szymanp135/Tura/doc/Tura_dokumentacja.pdf

# Tura

Fizyczna implementacja maszyny Turinga

Paweł Szymański

Luty 2026

## Spis treści

1 Wstęp | 2
2 Opis zastosowanego modelu | 2
3 Model Działania | 5
4 Fizyczny Opis Działania | 22

1

## 1 Wstęp

Niewątpliwie jednym z najważniejszych osiągnięć ludzkości XX wieku jest wynalazek będący abstrakcyjnym modelem matematycznym. Mowa
oczywiście | o | maszynie | Turinga. | Dzięki | temu | rewolucyjnemu
wynalazkowi dziś jako ludzkość jesteśmy w stanie automatyzować zaawansowane zagadnienia, jak na przykład obróbka i montaż produktów w fabrykach czy rozwiązywanie skomplikowanych obliczeń
matematycznych. | Bez | maszyn | Turinga | nie | mielibyśmy | dziś
komputerów, urządzeń tak uniwersalnych i wszechstronnych jak te które znamy, z których korzystamy i z którego najprawdopodobniej czytelnik czyta tę dokumentację. W ramach urzeczywistnienia matematycznego modelu maszyny Turinga powstał projekt „Tura”, którego zadaniem jest fizyczna implementacja pewnego modelu maszyny. Z racji, iż podstawowy model zakłada nieograniczoną długość taśmy, implementajca maszyny jako takiej nie jest możliwa. Jednak pewien podzbiór maszyn zakłada skończoną długość taśmy. Tym modelem jest maszyna Turinga ograniczona liniowo. Implementowany model, w celu uproszczenia elektronicznych układów, dodatkowo posiada własność akceptującego stanu zatrzymującego.

## 2 Opis zastosowanego modelu

Definicja maszyny Turinga M jest następująca:

M = (Q, Γ, Σ, δ, q0, B, F),

gdzie:

- Q - zbiór stanów,
- Γ - alfabet taśmy,

2

- Σ - alfabet słowa wejściowego, Σ ⊆ Γ,
- δ - funkcja przejścia, δ : Q×Γ → Q×Γ× D, gdzie D jest zbiorem możliwych ruchów głowicy maszyny, D = {L, R},
- q0 - stan początkowy, q0 ∈ Q,
- B - symbol pusty, B ∈ Γ\Σ,
- F - zbiór stanów akceptujących.

Żeby znaleźć jakieś intuicyjne wyobrażenie jak taka maszyna może wyglądać i funkcjonować możemy wyobrazić sobie skrzynkę, w której zamknięty jest układ sterujący urządzeniem oraz przede wszystkim przechowujący jego obecny stan. Obok skrzynki umieszczona jest taśma z symbolami. Ma ona swój początek z jednej strony, jednak z drugiej nie ma końca - jest jednostronnie nieskończona. Taśmę i skrzynkę łączy głowica - czyta ona lub nadpisuje jeden symbol na taśmie oraz przesuwa się po niej. Na początku działania maszyny głowica znajduje się nad skrajnym symbolem taśmy.

Działanie takiej maszyny można porównać do następującej sekwencji czynów:

1. Głowica odczytuje symbol s ∈ Γ z taśmy.
2. Skrzynka na podstawie obecnego stanu q ∈ Q oraz s oblicza nowy stan, symol i kierunek przesunięcia głowicy za pomocą funkcji przejścia: δ(q, s) = (q

′

, s′
, d).
3. Skrzynka zmienia obecny stan z q na q

′
4. Głowica nadpisuje symbol na taśmie s na s

′
, po czym przesuwa się
o jeden symbol się zgodnie z kierunkiem d.

3

5. Sekwencja ta jest powtarzana dopóty, dopóki maszyna nie osiągnie stanu akceptującego.

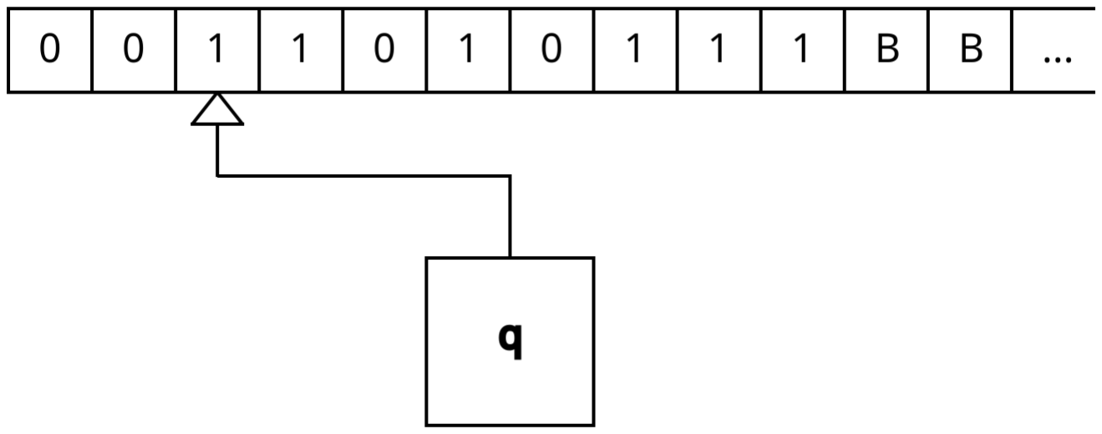
[picture p2: figure]

Rysunek 1: Przykładowa wizualizacja maszyny Turinga

Fizyczne urządzenie cechuje się dodatkowo ograniczoną długością taśmy oraz jednym stanem akceptującym zatrzymującym działanie maszyny. Formalnie ograniczoną długość taśmy można uzyskać poprzez wstawienie wartowników na jej początku oraz końcu, jednak te działanie pozostawione jest dla użytkownika maszyny do samodzielnej implementacji. Zaś stan akceptujący zatrzymujący działanie maszyny oznacza, że F ma dokładnie jeden stan akceptujący qA, po którego osiągnięciu urządzenie zatrzymuje pracę.

4

## 3 Model Działania

### 3.1 Opis Ogólny

Działanie maszyny w skrócie opiera się o zaprogramowanie urządzenia, wykonanie obliczeń i pobranie wyniku.

- Programowanie | odbywa | się | poprzez | zapisanie | wejściowej
zawartości taśmy oraz funkcji przejścia w trzech blokach pamięci (bloku symboli taśmy, bloku funkcji przejścia symbolu tasmy oraz bloku funkcji przejścia stanu).
- Wykonanie obliczeń to uruchomienie urządzenia i pozostawienie w działaniu do czasu osiągnięcia stanu akceptującego.
- Pobranie wyniku jest odczytem zawartości taśmy po zakończeniu działania maszyny.

### 3.2 Opis Szczegółowy

Opis szczegółowy wchodzi już w fizyczną implementację urządzenia. Jego celem jest staranny opis modułów, sygnałów, ich wzajemnej interakcji oraz dokładne wytłumaczenie działania maszyny. Opis w znacznej mierze opiera się o schematy KiCad i korzysta ze stosowanych w nich oznaczeń oraz nazw.

### 3.2.1 Moduły

Maszyna została podzielona na 11 modułów w celu oznakowania jednostek odpowiedzialnych za poszczególne funkcje. Moduły w schematach KiCad zostały otoczone ciemnożłółtymi ramkami i podpisane niebieskim tekstem lub jedynie podpisane niebieskim tekstem w przypadku modułów jednoelementowych.

| | 5

TAPE – Blok pamięci symulujący taśmę. Każda komórka pamięci reprezentuje jeden symbol taśmy. Pojedynczy symbol taśmy składa się z 7 bitów;

TAPE SYMBOL REGISTER – Rejestr przechowujący jeden symbol taśmy. Jest on potrzebny do chwilowego przechowania odczytanego symbolu na czas zapisu nowego do TAPE;

SYMBOL TRANSLATOR – Blok pamięci symulujący funkcję przejścia dla zadanego symbolu oraz stanu zwracający wynik w formie symbolu taśmy (7 bitów) oraz kierunku ruchu głowicy (1 bit);

STATE TRANSLATOR – Blok pamięci symulujący funkcję przejścia dla zadanego symbolu oraz stanu zwracający wynik w formie stanu (8 bitów);

STATE REGISTER – Rejestr przechowujący obecny stan maszyny;

HEADER POSITION – | Zbiór | liczników | binarnych | z | możliwością
inkrementacji oraz dekrementacji reprezentujący usytuowanie głowicy na taśmie (wskazuje obecnie wybrany symbol w TAPE);
HEADER POSITION DIRECTION DISASSEMBLY – | Prosty | multiplekser
sygnału zmiany wartości HEADER POSITION w zależności od kierunku zmiany;
HEADER POSITION CLOCK SYNCHRONIZATION – | Bramka | AND
synchronizująca sygnał zmiany wartości HEADER POSITION z zegarem;

STEP EXECUTION STATE REGISTER – Rejestr przechowujący obecny stan wykonywania ruchu maszyny. Ze względu na brak praktycznego rozwiązania jednoczesnego odczytu i zapisu symbolu taśmy, przeprowadzenie przejścia zostało podzielone na

| | 6

dwa ruchy rozdzielające te operacje; stąd dwa stany wykonania ruchu;

IN-PROGRAM CONTROL LINES BUFFERS – Zestaw buforów oddzielający kontrolne linie sygnałowe generowane przez interfejs zewnętrzny od tych wewnęrznych;

IN-OPERATION CONTROL LINES BUFFER – | Bufor | oddzielający
wewnętrzne linie kontrolne od tych generowanych przez urządzenie podczas pracy;

### 3.2.2 Sygnały

Oznaczenie sygnałów jest takie same jak oznaczenia zastosowane w schematach KiCad. Sygnały z poprzeczką nad nazwą oznaczają, że sygnał jest aktywny dla niskiego poziomu, zaś nieaktywny dla wysokiego.

Lista sygnałów:

D0...7 – Magistrala danych używana do programowania i odczytu danych z maszyny;

S0...6 – Magistrala symbolu taśmy;

SR0...6 – Magistrala symbolu taśmy zapisanego w TAPE SYMBOL REGISTER;

Q0...7 – Magistrala stanu;

QR0...7 – Magistrala stanu zapisanego w STATE REGISTER;

H0...15 – Magistrala z wartością licznika HEADER POSITION;

7

CLK – Sygnał zegarowy wyznaczający rytm pracy; każda zmiana sygnału ze stanu niskiego do wysokiego powoduje przejście STEP EXECUTION STATE REGISTER do następnego stanu; działa pod warunkiem aktywnego sygnału CLK_EN;

CLK_EN – Kontroluje dopływ sygnału CLK do STEP EXECUTION STATE REGISER;

DIR – Ustala kierunek zmiany wartości HEADER POSITION. Wysoki stan sygnału znaczy inkrementację, niski stan dekrementację;

HP_EN – Dopuszcza możliwość zmiany wartości HEADER POSITION;

HP_EN_CLK – sygnał HP_EN zsynchronizowany z zegarem (CLK):
HP_EN_CLK | = | HP_EN · CLK; synchronizuje zmianę wartości
HEADER POSITION z zegarem;

DIR_UP – Decyduje o inkrementacji wartości HEADER POSITION; działa przy przejściu ze stanu niskiego do wysokiego;

DIR_DOWN – Decyduje o dekrementacji wartości HEADER POSITION; działa przy przejściu ze stanu niskiego do wysokiego;

RESET – Resetuje urządzenie, czyli ustawia STEP EXECUTION STATE REGISTER do stanu 0 oraz ustawia wartość HEADER POSITION na 0;

PROGRAM – Ustala tryb pracy. Poziom niski sygnału oznacza tryb programowania maszyny, poziom wysoki zaś tryb wykonywania programu;

PROGRAM – Przeciwieństwo sygnału PROGRAM; sygnał ten jest równoważny OPERATE – podany został jedynie dla czytelności schematu;

8

OPERATE – Przeciwieństwo sygnału PROGRAM. Niski poziom oznacza pracę urządzenia;

DDIR – Ustala kierunek przepływu danych z wewnętrznych modułów wybranych sygnałami CS0, CS1 na magistralę D0...7. Wysoki poziom sygnału oznacza zapis danych z inteferjsu zewnętrznego do modułów wewnątrz urządzenia. Niski poziom oznacza odczyt;

CS0, CS1 – Kombinacja tych sygnałów wybiera wewnętrzną magistralę, która zostanie połączona z zewnętrzną D0...7 oraz wewnętrzny moduł do odczytu/zapisu danych z wybranej magistrali (kierunek zależny od DDIR);

DT – Włącza przesył danych między wewnętrznymi modułami a intefrejsem zewnętrznym; aktywny dla niskiego poziomu;

TSR_WR – Zapisuje dane z magistrali symbolu taśmy S0...6 do TAPE SYMBOL REGISTER; zapis odbywa się podczas przejścia sygnału ze stanu niskiego do wysokiego;

SR_WR – Zapisuje dane z magistrali stanu Q0...7 do STATE REGISER; zapis odbywa się podczas przejścia sygnału ze stanu niskiego do wysokiego;

T_OE – Włącza wyjście danych z TAPE na magistralę S0...6; aktywny dla niskiego poziomu;

T_WE – Włącza zapis danych w TAPE z magistrali S0...6; aktywny dla niskiego poziomu;

SYT_OE – Włącza wyjście danych z SYMBOL TRANSLATOR na magistralę S0...6 oraz sygnał DIR_B; aktywny dla niskiego poziomu;

SYT_WE – Włącza zapis danych w SYMBOL TRANSLATOR z magistrali S0...6 oraz sygnału DIR_B; aktywny dla niskiego poziomu;

9

STT_OE – Włącza wyjście danych ze STATE TRANSLATOR na magistralę Q0...7; aktywny dla niskiego poziomu;

STT_WE – Włącza zapis danych w STATE TRANSLATOR z magistrali Q0...7; aktywny dla niskiego poziomu;

QR_OE – Włącza wyjście danych ze STATE REGISTER na magistralę D0...7; aktywny dla niskiego poziomu;

T_*E_E, SYT_*E_E, ST_*E_E, QR_OE_E – Sygnały odpowiadające tym bez sufiksu „_E”, będące połączone z nimi przez bufor U18 oraz będące wynikiem dekodera wyboru funkcji U19;

T_*E_B, SYT_OE_B, STT_OE_B, DIR_B – Sygnały odpowiadające tym bez sufiksu „_B”, będące połączone z nimi przez bufor U17. Są one sygnałami generowanymi przez maszynę podczas obliczeń potrzebnymi do poprawnej jej samodzielnej pracy;

SYMB_BUF – Włącza przepływ danych z TAPE lub SYMBOL TRANSLATOR (w zależności od wybranego urządzenia sygnałami CS0,1) na magistralę D0...7; aktywny dla niskiego poziomu;

STAT_BUF – Włącza przepływ danych ze STATE TRANSLATOR na magistralę D0...7; aktywny dla niskiego poziomu;

FINISH_STATE – Informuje o osiągnięciu przez maszynę stanu akceptującego i zarazem zatrzymującego pracę; aktywny dla niskiego poziomu.

SEST_STATE – | Wskazuje | obecny | stan | STEP EXECUTION STATE
REGISTER;

10

### 3.2.3 Interfejs zewnętrzny

W celu zasilenia urządzenia oraz komunikacji zastosowany został zewnętrzny interfejs w formie złącza krawędziowego. Składa się on z 17 wyjść sterujących oraz informujacych o stanie maszyny, 11 zasilających oraz 16 niepodpiętych do żadnych sygnałów. W sumie daje to 44 wyjścia. Wszystkie wspomniane sygnały (po za Vcc oraz Vss) zostały wyjaśnione w poprzednim podrozdziale. Wyjścia Vcc oraz Vss są wyjściami odpowiednio zasilania i uziemienia. Vcc powinno mieć napięcie +5V względem Vss.
By uniknąć zbyt podobnych oznaczeń, kierunki sygnałów zamiast „Wej/Wyj” zostały oznaczone angielskimi „In/Out”.

Tabela sygnałów interfejsu:

Num. wyjścia | Sygnały | Kierunek
1-8 | D0...7 | In/Out
9 | CLK | In
10 | RESET | In
11 | PROGRAM | In
12 | DDIR | In
13-14 | CS0,1 | In
15 | DT | In
16 | FINISH_STATE | Out
17 | SESR_STATE | Out

Tabela 1: Lista sygnałów interfejsu zewnętrznego

11

Num. wyjścia | Sygnały | Kierunek
19,21,23,25,27 | Vcc | —
18,20,22,24,26,28 | Vss | —
29-44 | — | —

Tabela 2: Lista sygnałów interfejsu zewnętrznego (cd.)

Oprócz interfejsu zewnętrznego na urządzeniu znajdują się trzy dodatkowe złącza: J2, J3 i J4. Służą one do odczytu wartości odpowiednio TAPE SYMBOL REGISTER, STATE REGISTER oraz HEAD POSITION (złącza te są podłączone do tych modułów bezpośrednio).

### 3.2.4 Programowanie

Programowanie | maszyny | odbywa | się | za | pomocą | interfejsu
zewnętrznego. Dzięki odpowiedniemu wykorzystaniu udostępnionych sygnałów użytkownik jest w stanie manipulować zawartością bloków pamięci TAPE, SYMBOL TRANSLATOR oraz STATE TRANSLATOR.

### 3.2.4.1 Przygotowanie maszyny do programowania

W celu rozpoczęcia programowania maszyny należy wpierw ją do tego przygotować. Zadanie to jest dość proste - wystarczy ustawić sygnał PROGRAM na niski poziom, po czym puścić puls sygnału RESET. Wykres czasowy znajduje się na stronie 15. na rysunku 2.

### 3.2.4.2 Programowanie modułu TAPE (taśmy)

Programowanie modułu TAPE zaczyna się przygotowaniem go do programowania, czyli wybraniem modułu, z użyciem sygnałów CS0,1, ustaleniem kierunku przepływu danych sygnałem DDIR - poziom wysoki

| | 12

dla zapisu - oraz puszczeniem pulsu sygnału RESET.
Następnie zapis słowa wejściowego taśmy odbywa się w pętli: ustala się sybol do zapisu na magistrali D0...6 (proszę zwrócić uwagę na indeks 0...6 - symbol ma 7 bitów), aktywuje się przesył danych (w tym przypadku zapis) do modułu pulsem sygnału DT oraz wysła się dwa pulsy zegara CLK w celu przejścia do następnej komórki pamięci przechowującej zawartość taśmy. Wykres czasowy znajduje się na stronie 16. na rysunku 3.

### 3.2.4.3 Programowanie modułu SYMBOL TRANSLATOR

Podobnie jak w przypadku programowania TAPE, SYMBOL TRANSLATOR również należy przygotować do programowania. W tym celu trzeba wybrać jedynie kierunek DDIR oraz puścić puls sygnału RESET.
Zapis pojedynczej wartości funkcji przejścia z wynikiem w postaci
symbolu | oraz | kierunku | przesunięcia | głowicy | jest | bardziej
skomplikowany w porównaniu do zapisu pojedynczego symbolu taśmy. Główny problem leży w określeniu, która wartość funkcji ma zostać wgrana do modułu, czyli która komórka pamięci ma być zapisana. Aby to sprecyzować należy dokonać zapisu w dwóch rejestrach, które bezpośrednio określają wskazywane miejsce w pamięci: TAPE SYMBOL REGISTER oraz STATE REGISTER. Te dwa rejestry odpowiadają argumentom funkcji przejścia: stanowi oraz symbolowi.
Zatem, żeby wskazać miejsce w pamięci modułu SYMBOL TRANSLATOR do którego należy zapisać wartość, trzeba wpierw wysłać symbol będący jednym z argumentów funkcji przejścia na magistralę D0...6, wybrać wewnętrzną magistralę S0...6 sygnałami CS0,1 oraz wysłać puls zegara w celu zapisania wartości magistrali w TAPE SYMBOL REGISTER. Następnie trzeba wysłać stan będący drugim z argumentów funkcji przejścia na magistralę D0...7, wybrać wewnętrzną magistralę Q0...7 sygnałami CS0,1 oraz wysłać puls zegara w celu zapisania wartości magistrali w STATE REGISTER.
| | | 13

Po tym miejsce w pamięci modułu SYMBOL TRANSLATOR jest wybrane i można przystąpić do zapisu symbolu oraz kierunku wartości funkcji przejścia. Osiąga się to za pomocą wyboru modułu sygnałami CS0,1, umieszczeniu danych do zapisu na magistrali D0...7 oraz puszczeniem pulsu sygnału.
W przypadku programowania wartości funkcji dla argumentu ze stanem akceptującym po wykonaniu zapisu do STATE REGISTER należy puścić puls sygnału RESET w celu wyjścia maszyny ze stanu zatrzymania pracy (zatrzymania wpływu zegara na przejścia między staniami STEP
EXECUTION STATE REGISTER). | Jednak | można | zauważyć, | że
programowanie tych przejść nie ma sensu ze względu na zatrzymanie pracy urządzenia zaraz po przejściu do stanu akceptującego. DT. Wykres czasowy znajduje się na stronie 17. na rysunku 4.

### 3.2.4.4 Programowanie modułu STATE TRANSLATOR

Programowanie STATE TRANSLATOR odbywa się w sposób bardzo zbliżony do SYBMOL TRANSLATOR. Wpierw należy przygotować moduł do programowania co dzieje się poprzez ustawienie kierunku sygnałem DDIR oraz puszczenie pulsu sygnału RESET.
Zapis pojedynczej wartości funkcji przejścia z wynikiem w postaci stanu wymaga dokładnie tego samego procesu wybrania komórki pamięci w STATE TRANSLATOR co w SYMBOL TRANSLATOR. Z tego tytułu opis tego zadania nie został tu omówiony (jednak wciąż znajduje się on na wykresie czasowym).
Po wybraniu miejsca w pamięci modułu STATE TRANSLATOR następuje zapis stanu wartości funkcji przejścia: wybierany jest moduł sygnałami CS0,1, umieszczana jest wartość na magistrali D0...7 oraz puszczony zostaje puls sygnału DT w celu zapisania danych w pamięci. Wykres czasowy znajduje się na stronie 18. na rysunku 5.

Po wykonaniu powyższych czynności, tj. zaprogramowaniu modułów

| 14

TAPE, SYMBOL TRANSLATOR oraz STATE TRANSLATOR urządzenie jest gotowe do wykonania zapisanego programu.

### 3.2.4.5 Wykresy czasowe

Poniżej znajdują się wykresy czasowe uprzednio opisanych czynności.

1 | 2 | 3 | 4 | 5 | 6 | 7 | 8 | 9 | 10 | 11 | 12 | 13 | 14 | 15 | 16 | 17 | 18

PROGRAM

RESET

Rysunek 2: Wykres czasowy przygotowania maszyny do programowania.

Na wykresie czasowym przygotowania maszyny do programowania kolumna 2 przedstawia przejście sygnału PROGRAM do stanu niskiego, kolumna 3 przedstawia puls sygnału RESET. Późniejsze kolumny utrzymują stany sygnałów; zostały umieszczone w celach estetycznych wykresu, podobnie jak ten tekst, który służy częściowemu wypełnieniu pustego miejsca do końca tej strony.

15

RESET

CS1

CS0

DDIR

D0...6

DT

CLK

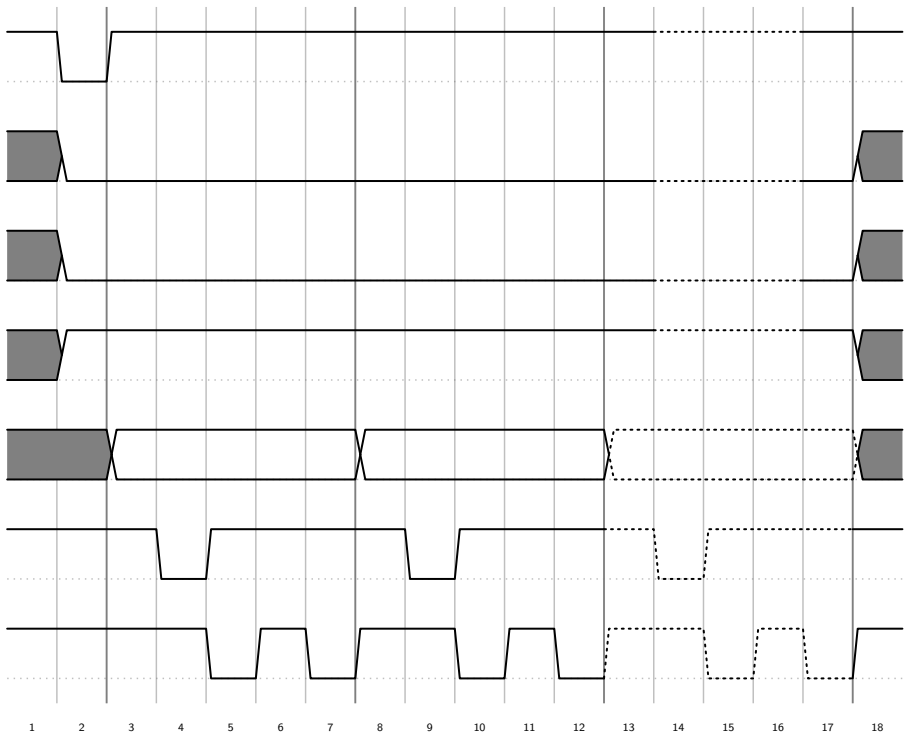
[picture p3: figure]

Rysunek 3: Wykres czasowy programowania TAPE.

Na wykresie czasowym programowania TAPE kolumny 1-2 reprezentują przygotowanie TAPE do programowania. 2-6 i 7-11 przedstawiają dwa pojedyncze zapisy symboli do dwóch kolejnych komórek pamięci w TAPE. Sygnały w kolumnach 13-17 zostały wykropkowane w celu wyeksponowania wielokrotnego powielenia operacji zapisu symbolu.

16

RESET

CS1

CS0

DDIR

D0...7

DT

CLK

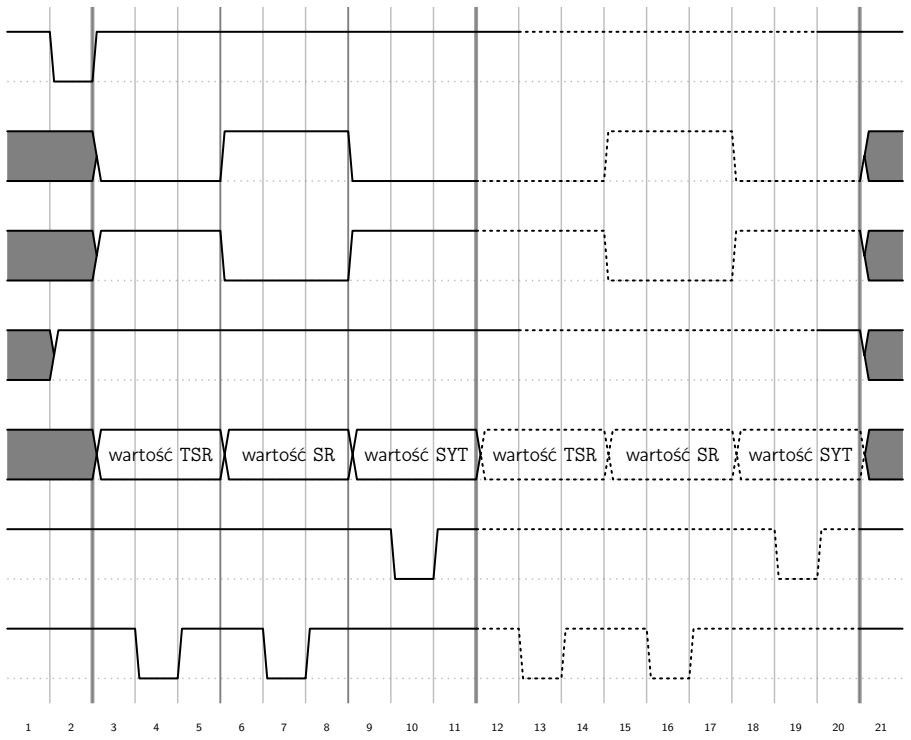
[picture p4: figure]
wartość; TSR; SYT

Rysunek 4: Wykres czasowy programowania SYMBOL TRANSLATOR. Oznaczenia:
TSR – TAPE SYMBOL REGISTER,
SR – STATE REGISTER,
SYT – SYMBOL TRANSLATOR.

Na wykresie czasowym programowania SYMBOL TRANSLATOR kolumny 1-2 reprezentują przygotowanie do programowania; 3-11 przedstawiają programowanie pojedynczej wartości: 3-5 odpowiada za zapis do TAPE SYMBOL REGISTER, 6-8 za zapis do STATE REGISTER, 9-11 za zapis do
SYMBOL TRANSLATOR. | Kolumny | 12-20 | również | przedstawiają
programowanie wartości do SYMBOL TRANSLATOR, jednak zostały one wykropkowane w celu wyeksponowania wielokrotnego powtórzenia tej operacji.

17

RESET

CS1

CS0

DDIR

D0...7

DT

CLK

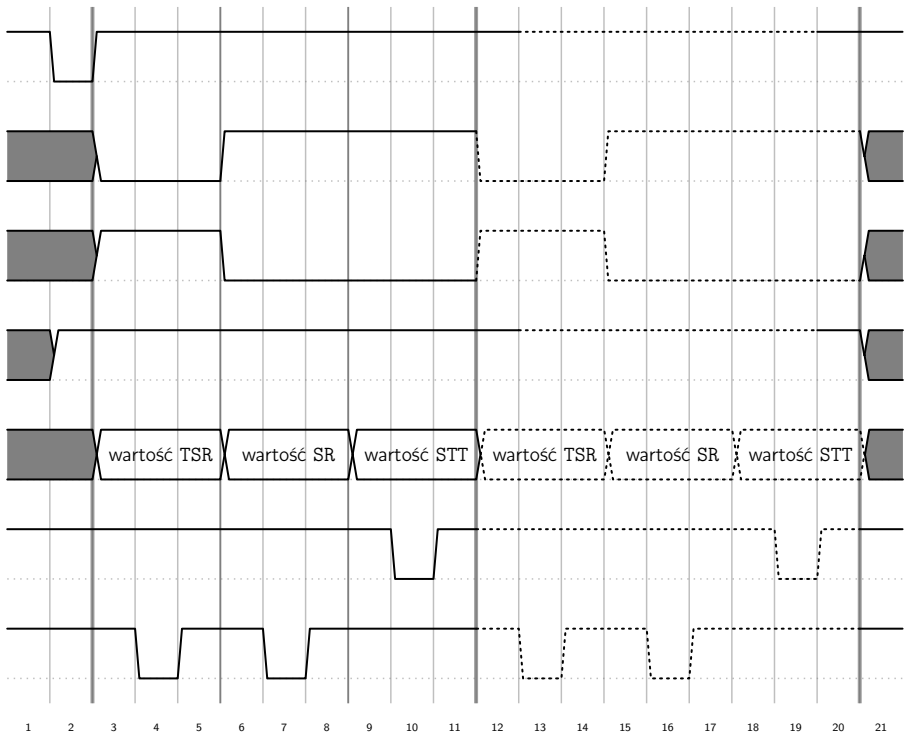
[picture p5: figure]
wartość; TSR; STT

Rysunek 5: Wykres czasowy programowania STATE TRANSLATOR. Oznaczenia:
TSR – TAPE SYMBOL REGISTER,
SR – STATE REGISTER,
STT – STATE TRANSLATOR.

Na wykresie czasowym programowania STATE TRANSLATOR kolumny 1-2 reprezentują przygotowanie do programowania; 3-11 przedstawiają programowanie pojedynczej wartości: 3-5 odpowiada za zapis do TAPE SYMBOL REGISTER, 6-8 za zapis do STATE REGISTER, 9-11 za zapis do
STATE TRANSLATOR. | Kolumny | 12-20 | również | przedstawiają
programowanie wartości do STATE TRANSLATOR, jednak zostały one wykropkowane w celu wyeksponowania wielokrotnego powtórzenia tej operacji.

18

### 3.2.5 Wykonanie Programu

Mając zaprogramowaną maszynę w celu uruchomienia i wykonania jej programu należy ją przygotować. Odbywa się to poprzez wysłanie pulsu sygnału RESET oraz przejście sygnału PROGRAM do stanu wysokiego.

1 | 2 | 3 | 4 | 5 | 6 | 7 | 8 | 9 | 10 | 11 | 12 | 13 | 14 | 15 | 16 | 17 | 18

PROGRAM

RESET

Rysunek 6: Wykres czasowy przygotowania maszyny do pracy.

Następnie całe działanie maszyny opiera się o sygnał zegara CLK. Każde dwa pulsy tego sygnału oznaczają wykonanie jednego ruchu urządzenia. Zegar powinien być dostarczony do momentu osiągnięcia przez maszynę stanu akceptującego zatrzymującego jej działanie.

1 | 2 | 3 | 4 | 5 | 6 | 7 | 8 | 9 | 10 | 11 | 12 | 13 | 14 | 15 | 16 | 17 | 18

CLK

Rysunek 7: Wykres czasowy przykładowago działania zegara.

### 3.2.6 Odczyt Wyniku Programu

Po osiągnięciu przez maszynę stanu akceptującego zatrzymującego jej działanie program został wykonany. W celu odczytu wyniku pracy należy wpierw określić sposób jego zapisu. Jednym z naturalnych sposobów jest umieszczenie wyniku na początku taśmy i pozostawienie głowicy nad pierwszym symbolem taśmy. Ten podrozdział opisze jak

19 odczytać wynik w przypadku zapisu rezultatu tym właśnie sposobem. Jeżeli użytkownik zapisuje wynik inną metodą, będzie musiał samodzielnie opracować sposób jego pobrania.

Odczyt wyniku we wspomnianej postaci jest dość prostym zadaniem. Najpierw trzeba przygotować maszynę do odczytu. Aby tego dokonać należy umieścić maszynę w stan programowania, czyli ustawić sygnał PROGRAM na poziom niski, puścić puls sygnału RESET, wybrać moduł TAPE sygnałami CS0,1 oraz ustalić kierunek przepływu danych na odczyt sygnałem DDIR ustawiając go na niski poziom. Następnie w pętli odczytuje się symbole z taśmy: ustawia się DT na poziom niski, odczytuje dane z magistrali D0...6, przywraca się DT na poziom wysoki, po czym puszcza się dwa pulsy zegara CLK.

Na wykresie czasowym kolumny 1-3 pokazują sekwencję przygotowania maszyny do odczytu. Kolumny 4-8, 9-13 oraz 14-18 reprezentują cykl odczytów pojedynczych symboli z TAPE. Segment 14-18 został wykropkowany w celu wyeksponowania wielokrotnego powtórzenia tej operacji.

S na wykresie oznacza moment w którym dane z TAPE na magistrali D0...6 są poprawne (gotowe do odczytu).

20

PROGRAM

RESET

CS1

CS0

DDIR

DT

D0...6

CLK

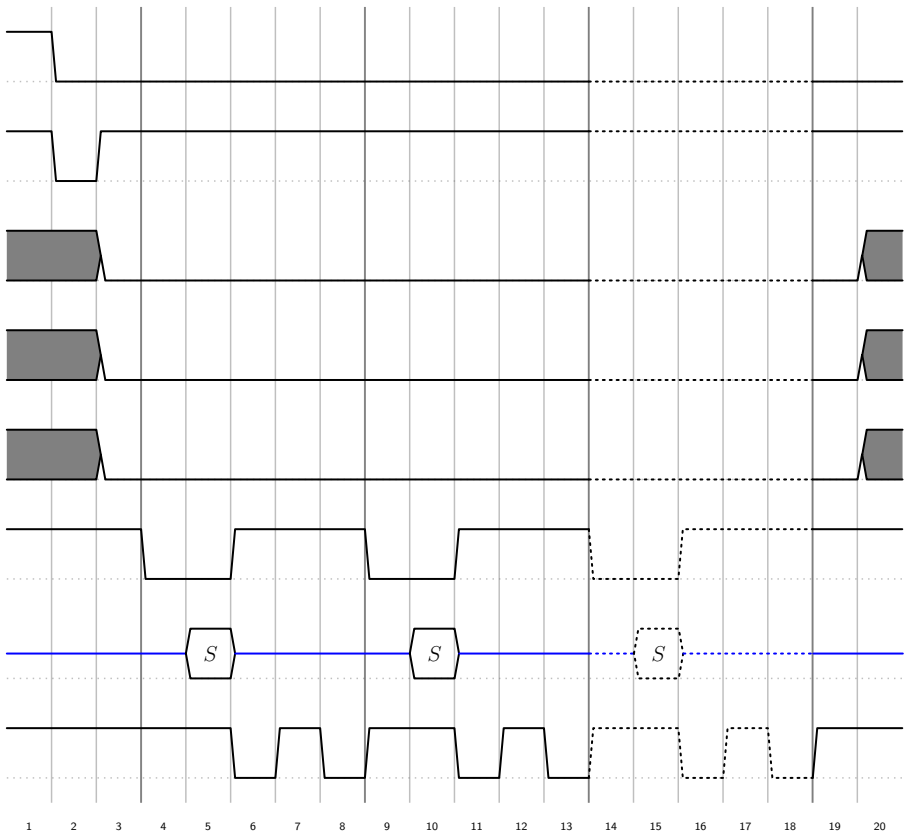
[picture p6: figure]

Rysunek 8: Wykres czasowy odczytu wyniku z maszyny.

21

## 4 Fizyczny Opis Działania

22
