szymanp135/Tura/turing_machine_driver/turing_driver.kicad_pcb

## KiCad design turing_machine_driver/turing_driver.kicad_pcb (2026-03-20)

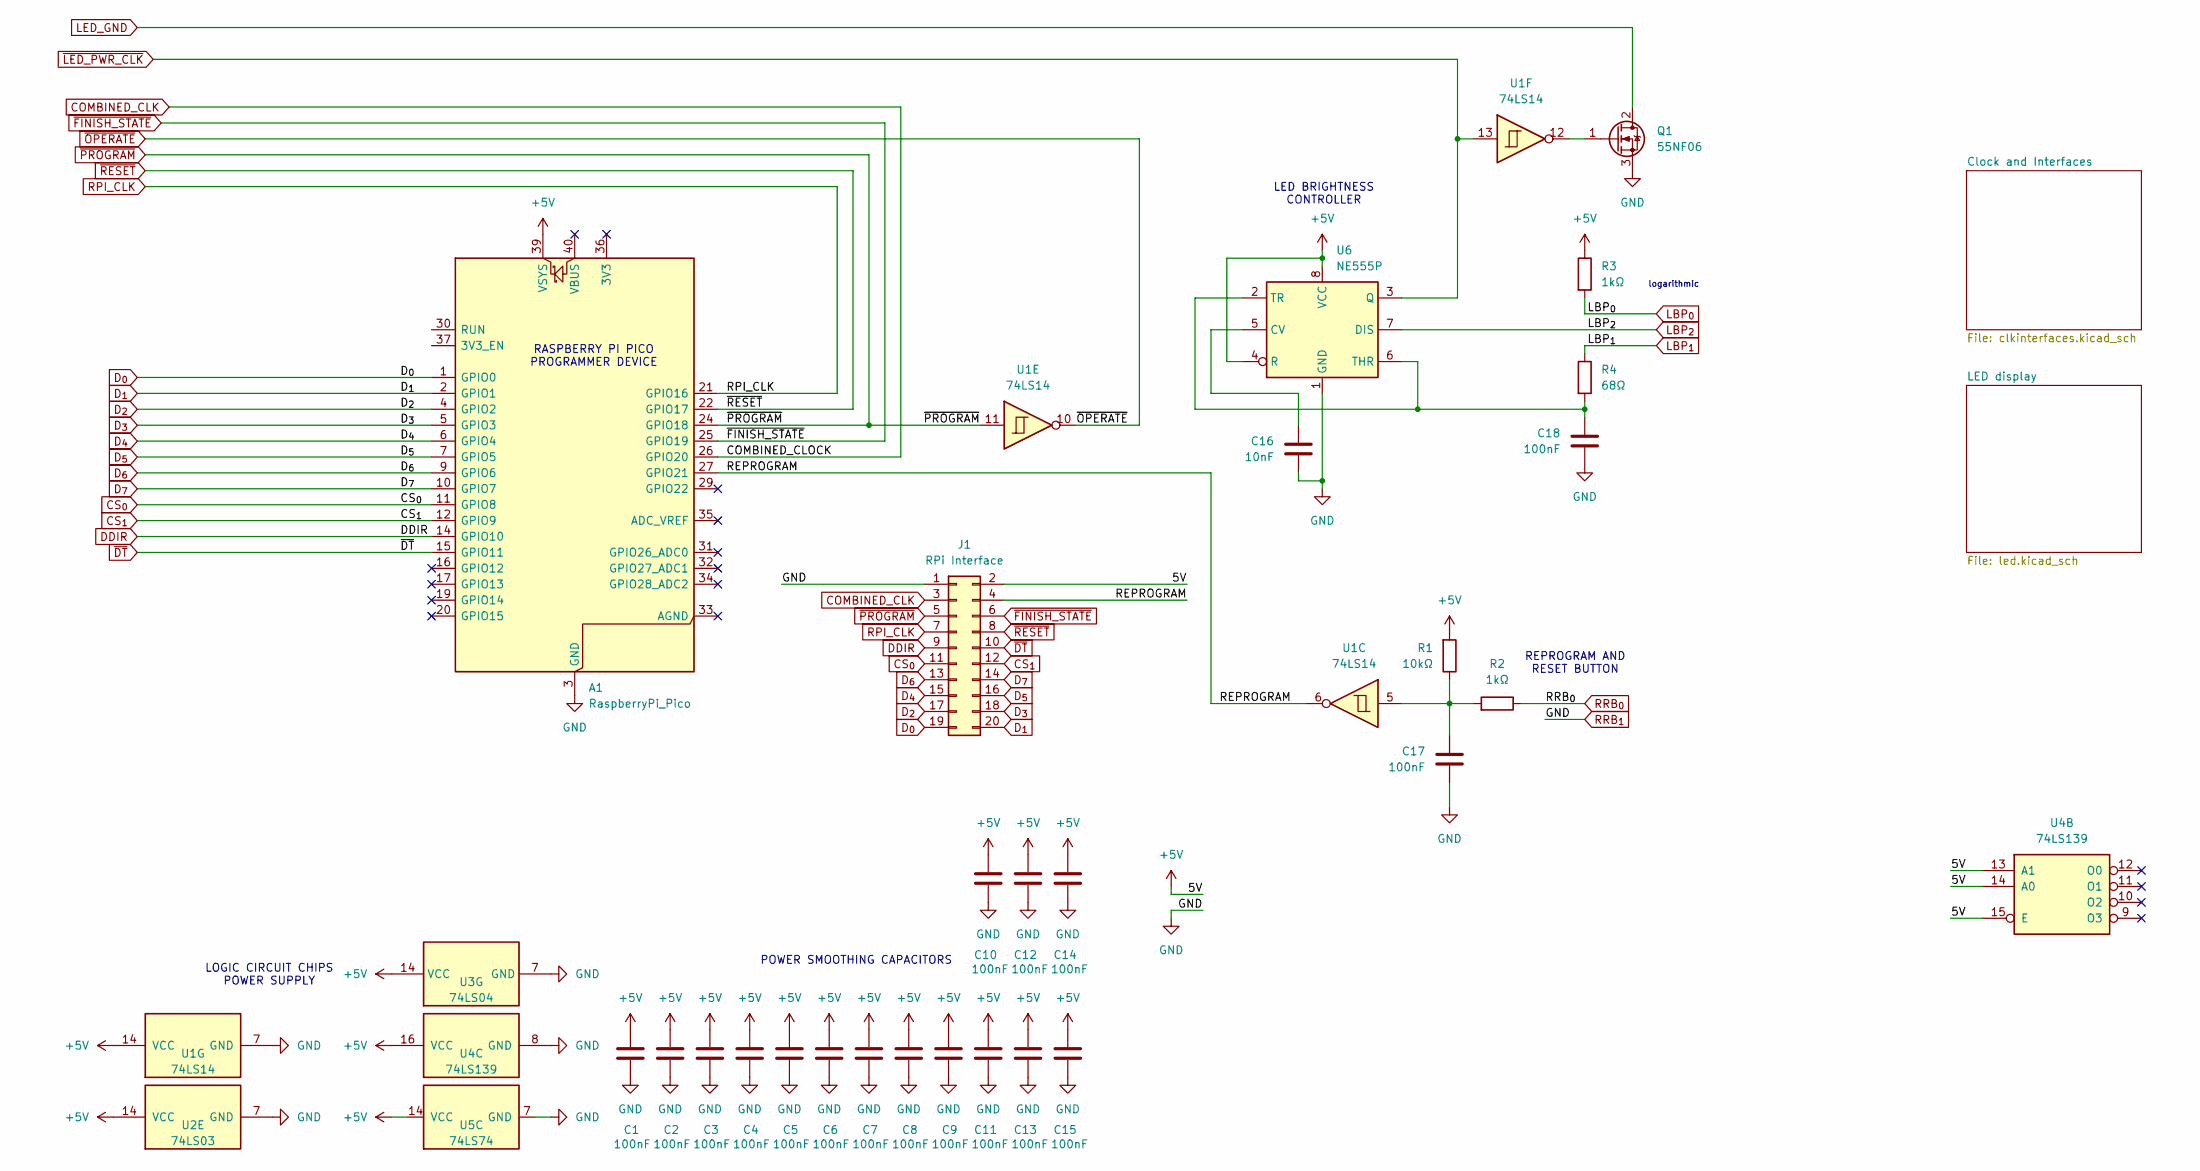
[picture p7: schematic turing_driver.kicad_sch]

Parts:
A1: RaspberryPi_Pico; RaspberryPi_Pico_Common_THT
C1, C2, C3, C4, C5, C6, C7, C8, C9, C10, C11, C12, C13, C14, C15, C17: 100nF; C_Disc_D3.8mm_W2.6mm_P2.50mm
C16: 10nF; C_Disc_D5.1mm_W3.2mm_P5.00mm
C18: 100nF; C_Disc_D5.1mm_W3.2mm_P5.00mm
J1: RPi Interface; IDC-Header_2x10_P2.54mm_Vertical
Q1: 55NF06; TO-220-3_Horizontal_TabDown
R1: 10kΩ; R_Axial_DIN0207_L6.3mm_D2.5mm_P10.16mm_Horizontal
R2, R3: 1kΩ; R_Axial_DIN0207_L6.3mm_D2.5mm_P10.16mm_Horizontal
R4: 68Ω; R_Axial_DIN0207_L6.3mm_D2.5mm_P10.16mm_Horizontal
U1: 74LS14; DIP-14_W7.62mm
U2: 74LS03; DIP-14_W7.62mm
U3: 74LS04; DIP-14_W7.62mm
U4: 74LS139; DIP-16_W7.62mm
U5: 74LS74; DIP-14_W7.62mm
U6: NE555P; DIP-8_W7.62mm

Connections:
/REPROGRAM: A1.27 (GPIO21), J1.4, U1.6
COMBINED_CLK: A1.26 (GPIO20), J1.3; also elsewhere on the board
CS_{0}: A1.11 (GPIO8), J1.11; also elsewhere on the board
CS_{1}: A1.12 (GPIO9), J1.12; also elsewhere on the board
DDIR: A1.14 (GPIO10), J1.9; also elsewhere on the board
D_{0}: A1.1 (GPIO0), J1.19; also elsewhere on the board
D_{1}: A1.2 (GPIO1), J1.20; also elsewhere on the board
D_{2}: A1.4 (GPIO2), J1.17; also elsewhere on the board
D_{3}: A1.5 (GPIO3), J1.18; also elsewhere on the board
D_{4}: A1.6 (GPIO4), J1.15; also elsewhere on the board
D_{5}: A1.7 (GPIO5), J1.16; also elsewhere on the board
D_{6}: A1.9 (GPIO6), J1.13; also elsewhere on the board
D_{7}: A1.10 (GPIO7), J1.14; also elsewhere on the board
LBP_{0}: R3.2; also elsewhere on the board
LBP_{1}: R4.1; also elsewhere on the board
LBP_{2}: U6.7 (DIS); also elsewhere on the board
LED_GND: Q1.2 (D); also elsewhere on the board
LPS_{0}: A1.39 (VSYS), C1.1, C2.1, C3.1, C4.1, C5.1, C6.1, C7.1, C8.1, C9.1, C10.1, C11.1, C12.1, C13.1, C14.1, C15.1, J1.2, R1.2, R3.1, U1.14 (VCC), U2.14 (VCC), U3.14 (VCC), U4.13 (A1), U4.14 (A0), U4.15 (E), U4.16 (VCC), U5.14 (VCC), U6.4 (R), U6.8 (VCC); also elsewhere on the board
unnamed: C17.1, R1.1, R2.2, U1.5
unnamed: Q1.1 (G), U1.12
unnamed: C16.1, U6.5 (CV)
unnamed: C18.1, R4.2, U6.2 (TR), U6.6 (THR)
RPI_CLK: A1.21 (GPIO16), J1.7; also elsewhere on the board
RRB_{0}: R2.1; also elsewhere on the board
RRB_{1}: A1.3 (GND), A1.8 (GND), A1.13 (GND), A1.18 (GND), A1.23 (GND), A1.28 (GND), A1.38 (GND), C1.2, C2.2, C3.2, C4.2, C5.2, C6.2, C7.2, C8.2, C9.2, C10.2, C11.2, C12.2, C13.2, C14.2, C15.2, C16.2, C17.2, C18.2, J1.1, Q1.3 (S), U1.7 (GND), U2.7 (GND), U3.7 (GND), U4.8 (GND), U5.7 (GND), U6.1 (GND); also elsewhere on the board
~DT: A1.15 (GPIO11), J1.10; also elsewhere on the board
~FINISH_STATE: A1.25 (GPIO19), J1.6; also elsewhere on the board
~LED_PWR_CLK: U1.13, U6.3 (Q); also elsewhere on the board
~OPERATE: U1.10; also elsewhere on the board
~PROGRAM: A1.24 (GPIO18), J1.5, U1.11; also elsewhere on the board
~RESET: A1.22 (GPIO17), J1.8; also elsewhere on the board

Notes on the sheet:
RASPBERRY PI PICO PROGRAMMER DEVICE
LOGIC CIRCUIT CHIPS POWER SUPPLY
REPROGRAM AND RESET BUTTON
POWER SMOOTHING CAPACITORS
logarithmic
LED BRIGHTNESS CONTROLLER

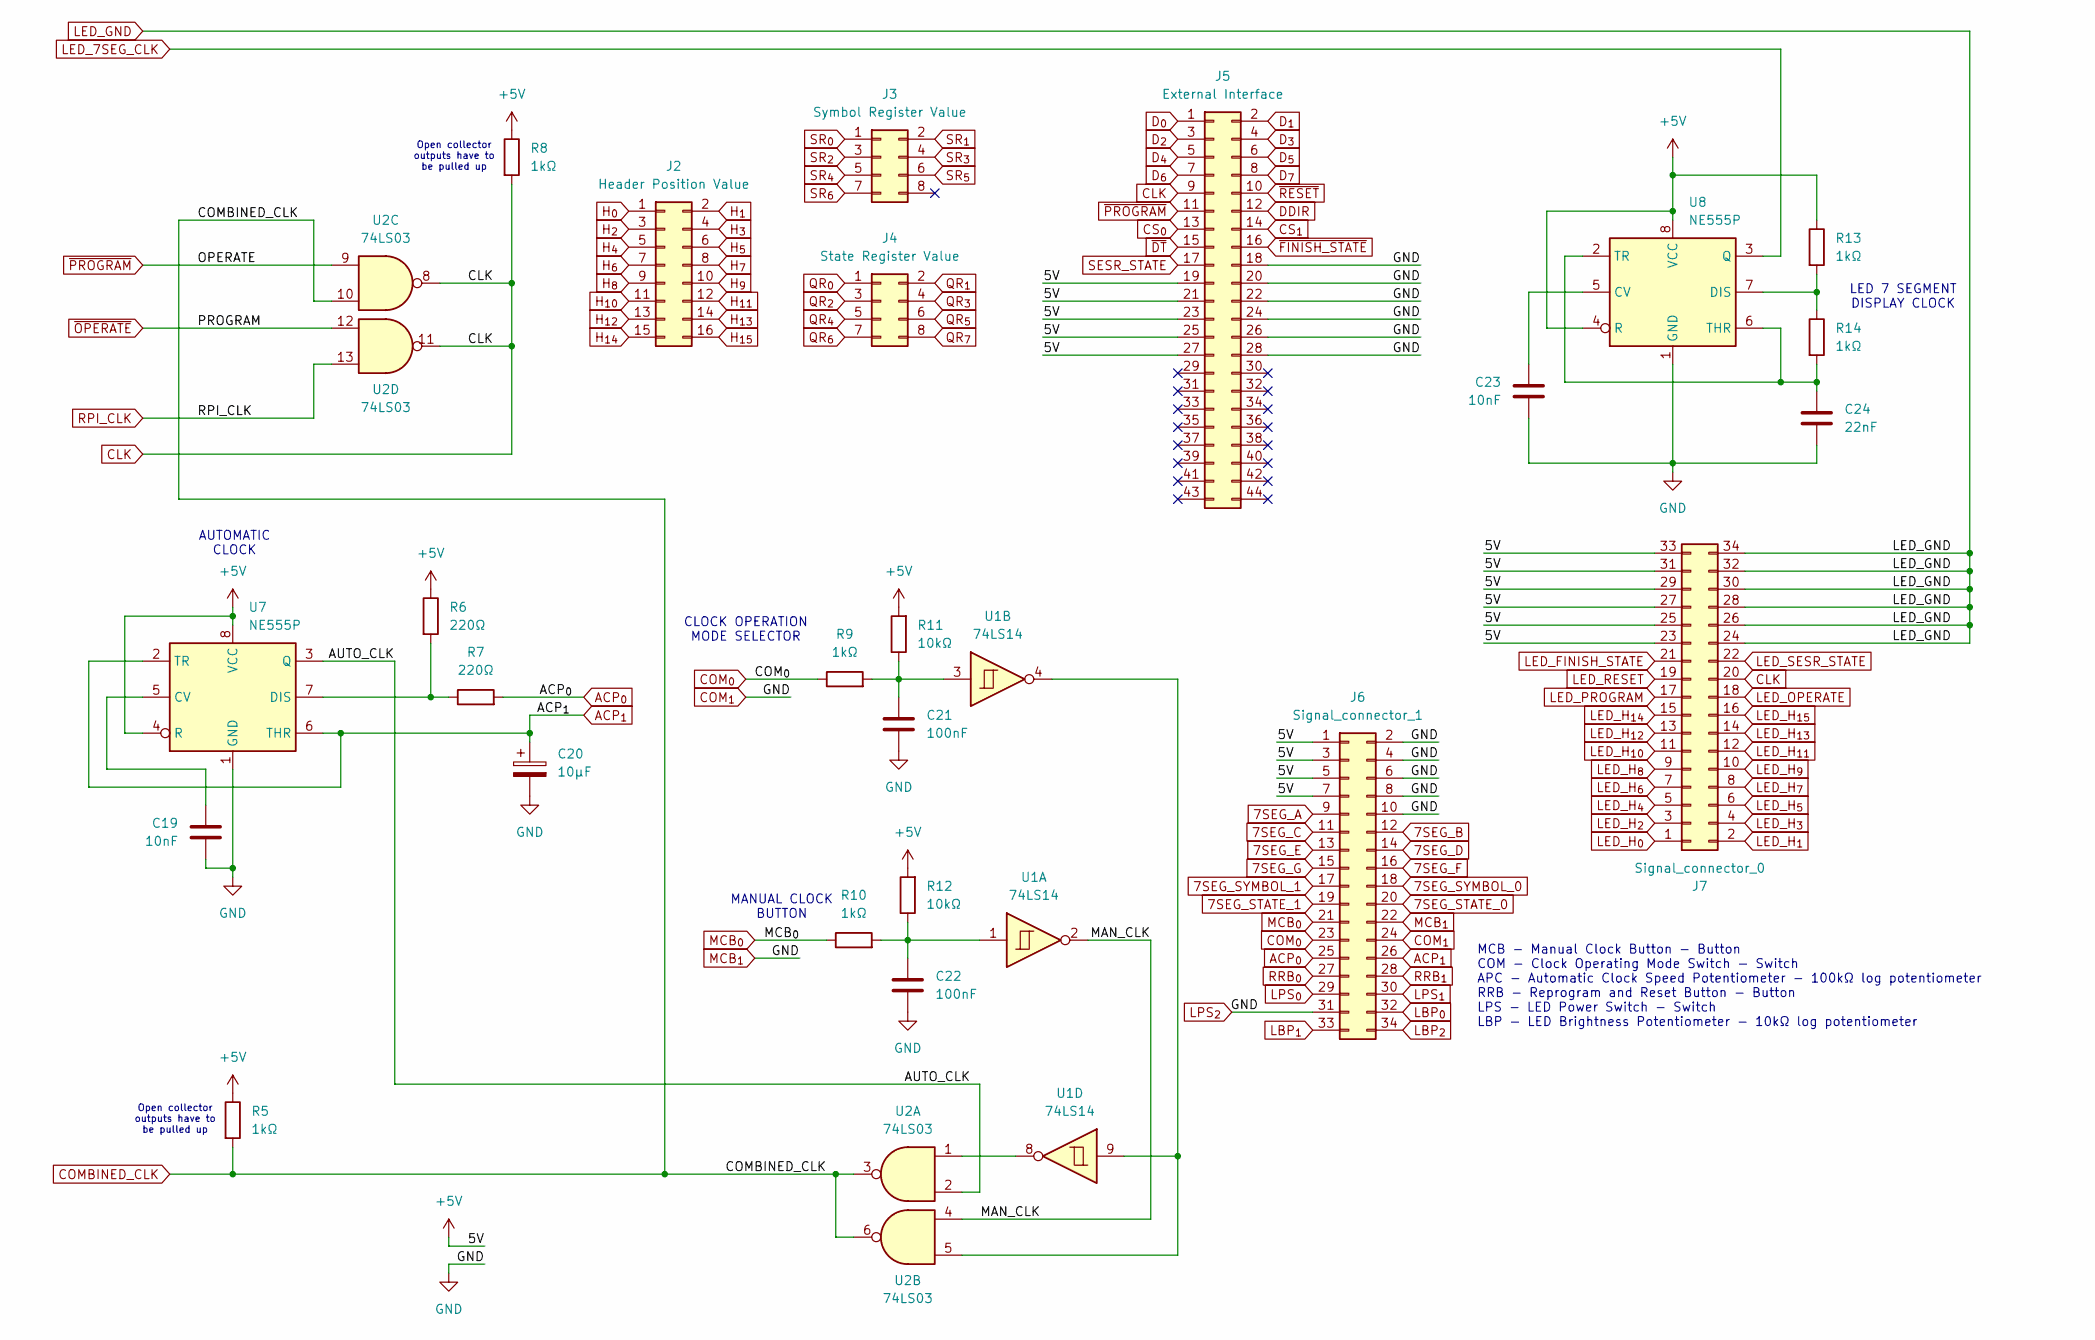
[picture p8: schematic clkinterfaces.kicad_sch]

Parts:
C19, C23: 10nF; C_Disc_D5.1mm_W3.2mm_P5.00mm
C20: 10µF; CP_Radial_D5.0mm_P2.00mm
C21, C22: 100nF; C_Disc_D3.8mm_W2.6mm_P2.50mm
C24: 22nF; C_Disc_D5.1mm_W3.2mm_P5.00mm
J2: Header Position Value; IDC-Header_2x08_P2.54mm_Vertical
J3: Symbol Register Value; IDC-Header_2x04_P2.54mm_Vertical
J4: State Register Value; IDC-Header_2x04_P2.54mm_Vertical
J5: External Interface; Connector_Edge_2x22pin_odd
J6: Signal_connector_1; Connector_Edge_2x17pin_odd
J7: Signal_connector_0; Connector_Edge_2x17pin_odd
R5, R8, R9, R10, R13, R14: 1kΩ; R_Axial_DIN0207_L6.3mm_D2.5mm_P10.16mm_Horizontal
R6, R7: 220Ω; R_Axial_DIN0207_L6.3mm_D2.5mm_P10.16mm_Horizontal
R11, R12: 10kΩ; R_Axial_DIN0207_L6.3mm_D2.5mm_P10.16mm_Horizontal
U1: 74LS14; DIP-14_W7.62mm
U2: 74LS03; DIP-14_W7.62mm
U7, U8: NE555P; DIP-8_W7.62mm

Connections:
7SEG_A: J6.9; also elsewhere on the board
7SEG_B: J6.12; also elsewhere on the board
7SEG_C: J6.11; also elsewhere on the board
7SEG_D: J6.14; also elsewhere on the board
7SEG_E: J6.13; also elsewhere on the board
7SEG_F: J6.16; also elsewhere on the board
7SEG_G: J6.15; also elsewhere on the board
7SEG_STATE_0: J6.20; also elsewhere on the board
7SEG_STATE_1: J6.19; also elsewhere on the board
7SEG_SYMBOL_0: J6.18; also elsewhere on the board
7SEG_SYMBOL_1: J6.17; also elsewhere on the board
/Clock and Interfaces/AUTO_CLK: U2.2, U7.3 (Q)
/Clock and Interfaces/MAN_CLK: U1.2, U2.4
ACP_{0}: J6.25, R7.2
ACP_{1}: C20.1, J6.26, U7.2 (TR), U7.6 (THR)
CLK: J5.9, J7.20, R8.2, U2.8, U2.11; also elsewhere on the board
COMBINED_CLK: R5.2, U2.3, U2.6, U2.10; also elsewhere on the board
COM_{0}: J6.23, R9.1
CS_{0}: J5.13; also elsewhere on the board
CS_{1}: J5.14; also elsewhere on the board
DDIR: J5.12; also elsewhere on the board
D_{0}: J5.1; also elsewhere on the board
D_{1}: J5.2; also elsewhere on the board
D_{2}: J5.3; also elsewhere on the board
D_{3}: J5.4; also elsewhere on the board
D_{4}: J5.5; also elsewhere on the board
D_{5}: J5.6; also elsewhere on the board
D_{6}: J5.7; also elsewhere on the board
D_{7}: J5.8; also elsewhere on the board
H_{0}: J2.1; also elsewhere on the board
H_{1}: J2.2; also elsewhere on the board
H_{2}: J2.3; also elsewhere on the board
H_{3}: J2.4; also elsewhere on the board
H_{4}: J2.5; also elsewhere on the board
H_{5}: J2.6; also elsewhere on the board
H_{6}: J2.7; also elsewhere on the board
H_{7}: J2.8; also elsewhere on the board
H_{8}: J2.9; also elsewhere on the board
H_{9}: J2.10; also elsewhere on the board
H_{10}: J2.11; also elsewhere on the board
H_{11}: J2.12; also elsewhere on the board
H_{12}: J2.13; also elsewhere on the board
H_{13}: J2.14; also elsewhere on the board
H_{14}: J2.15; also elsewhere on the board
H_{15}: J2.16; also elsewhere on the board
LBP_{0}: J6.32; also elsewhere on the board
LBP_{1}: J6.33; also elsewhere on the board
LBP_{2}: J6.34; also elsewhere on the board
LED_7SEG_CLK: U8.3 (Q); also elsewhere on the board
LED_FINISH_STATE: J7.21; also elsewhere on the board
LED_GND: J7.24, J7.26, J7.28, J7.30, J7.32, J7.34; also elsewhere on the board
LED_H_{0}: J7.1; also elsewhere on the board
LED_H_{1}: J7.2; also elsewhere on the board
LED_H_{2}: J7.3; also elsewhere on the board
LED_H_{3}: J7.4; also elsewhere on the board
LED_H_{4}: J7.5; also elsewhere on the board
LED_H_{5}: J7.6; also elsewhere on the board
LED_H_{6}: J7.7; also elsewhere on the board
LED_H_{7}: J7.8; also elsewhere on the board
LED_H_{8}: J7.9; also elsewhere on the board
LED_H_{9}: J7.10; also elsewhere on the board
LED_H_{10}: J7.11; also elsewhere on the board
LED_H_{11}: J7.12; also elsewhere on the board
LED_H_{12}: J7.13; also elsewhere on the board
LED_H_{13}: J7.14; also elsewhere on the board
LED_H_{14}: J7.15; also elsewhere on the board
LED_H_{15}: J7.16; also elsewhere on the board
LED_OPERATE: J7.18; also elsewhere on the board
LED_PROGRAM: J7.17; also elsewhere on the board
LED_RESET: J7.19; also elsewhere on the board
LED_SESR_STATE: J7.22; also elsewhere on the board
LPS_{0}: J5.19, J5.21, J5.23, J5.25, J5.27, J6.1, J6.3, J6.5, J6.7, J6.29, J7.23, J7.25, J7.27, J7.29, J7.31, J7.33, R5.1, R6.1, R8.1, R11.2, R12.2, R13.1, U7.4 (R), U7.8 (VCC), U8.4 (R), U8.8 (VCC); also elsewhere on the board
LPS_{1}: J6.30; also elsewhere on the board
MCB_{0}: J6.21, R10.1
unnamed: C21.1, R9.2, R11.1, U1.3
unnamed: C22.1, R10.2, R12.1, U1.1
unnamed: U1.4, U1.9, U2.5
unnamed: U1.8, U2.1
unnamed: C19.1, U7.5 (CV)
unnamed: R6.2, R7.1, U7.7 (DIS)
unnamed: C23.1, U8.5 (CV)
unnamed: R13.2, R14.1, U8.7 (DIS)
unnamed: C24.1, R14.2, U8.2 (TR), U8.6 (THR)
QR_{0}: J4.1; also elsewhere on the board
QR_{1}: J4.2; also elsewhere on the board
QR_{2}: J4.3; also elsewhere on the board
QR_{3}: J4.4; also elsewhere on the board
QR_{4}: J4.5; also elsewhere on the board
QR_{5}: J4.6; also elsewhere on the board
QR_{6}: J4.7; also elsewhere on the board
QR_{7}: J4.8; also elsewhere on the board
RPI_CLK: U2.13; also elsewhere on the board
RRB_{0}: J6.27; also elsewhere on the board
RRB_{1}: C19.2, C20.2, C21.2, C22.2, C23.2, C24.2, J5.18, J5.20, J5.22, J5.24, J5.26, J5.28, J6.2, J6.4, J6.6, J6.8, J6.10, J6.22, J6.24, J6.28, J6.31, U7.1 (GND), U8.1 (GND); also elsewhere on the board
SESR_STATE: J5.17; also elsewhere on the board
SR_{0}: J3.1; also elsewhere on the board
SR_{1}: J3.2; also elsewhere on the board
SR_{2}: J3.3; also elsewhere on the board
SR_{3}: J3.4; also elsewhere on the board
SR_{4}: J3.5; also elsewhere on the board
SR_{5}: J3.6; also elsewhere on the board
SR_{6}: J3.7; also elsewhere on the board
~DT: J5.15; also elsewhere on the board
~FINISH_STATE: J5.16; also elsewhere on the board
~OPERATE: U2.12; also elsewhere on the board
~PROGRAM: J5.11, U2.9; also elsewhere on the board
~RESET: J5.10; also elsewhere on the board

Notes on the sheet:
AUTOMATIC CLOCK
Open collector outputs have to be pulled up
LED 7 SEGMENT DISPLAY CLOCK
MCB - Manual Clock Button - Button COM - Clock Operating Mode Switch - Switch APC - Automatic Clock Speed Potentiometer - 100kΩ log potentiometer RRB - Reprogram and Reset Button - Button LPS - LED Power Switch - Switch LBP - LED Brightness Potentiometer - 10kΩ log potentiometer
MANUAL CLOCK BUTTON
CLOCK OPERATION MODE SELECTOR

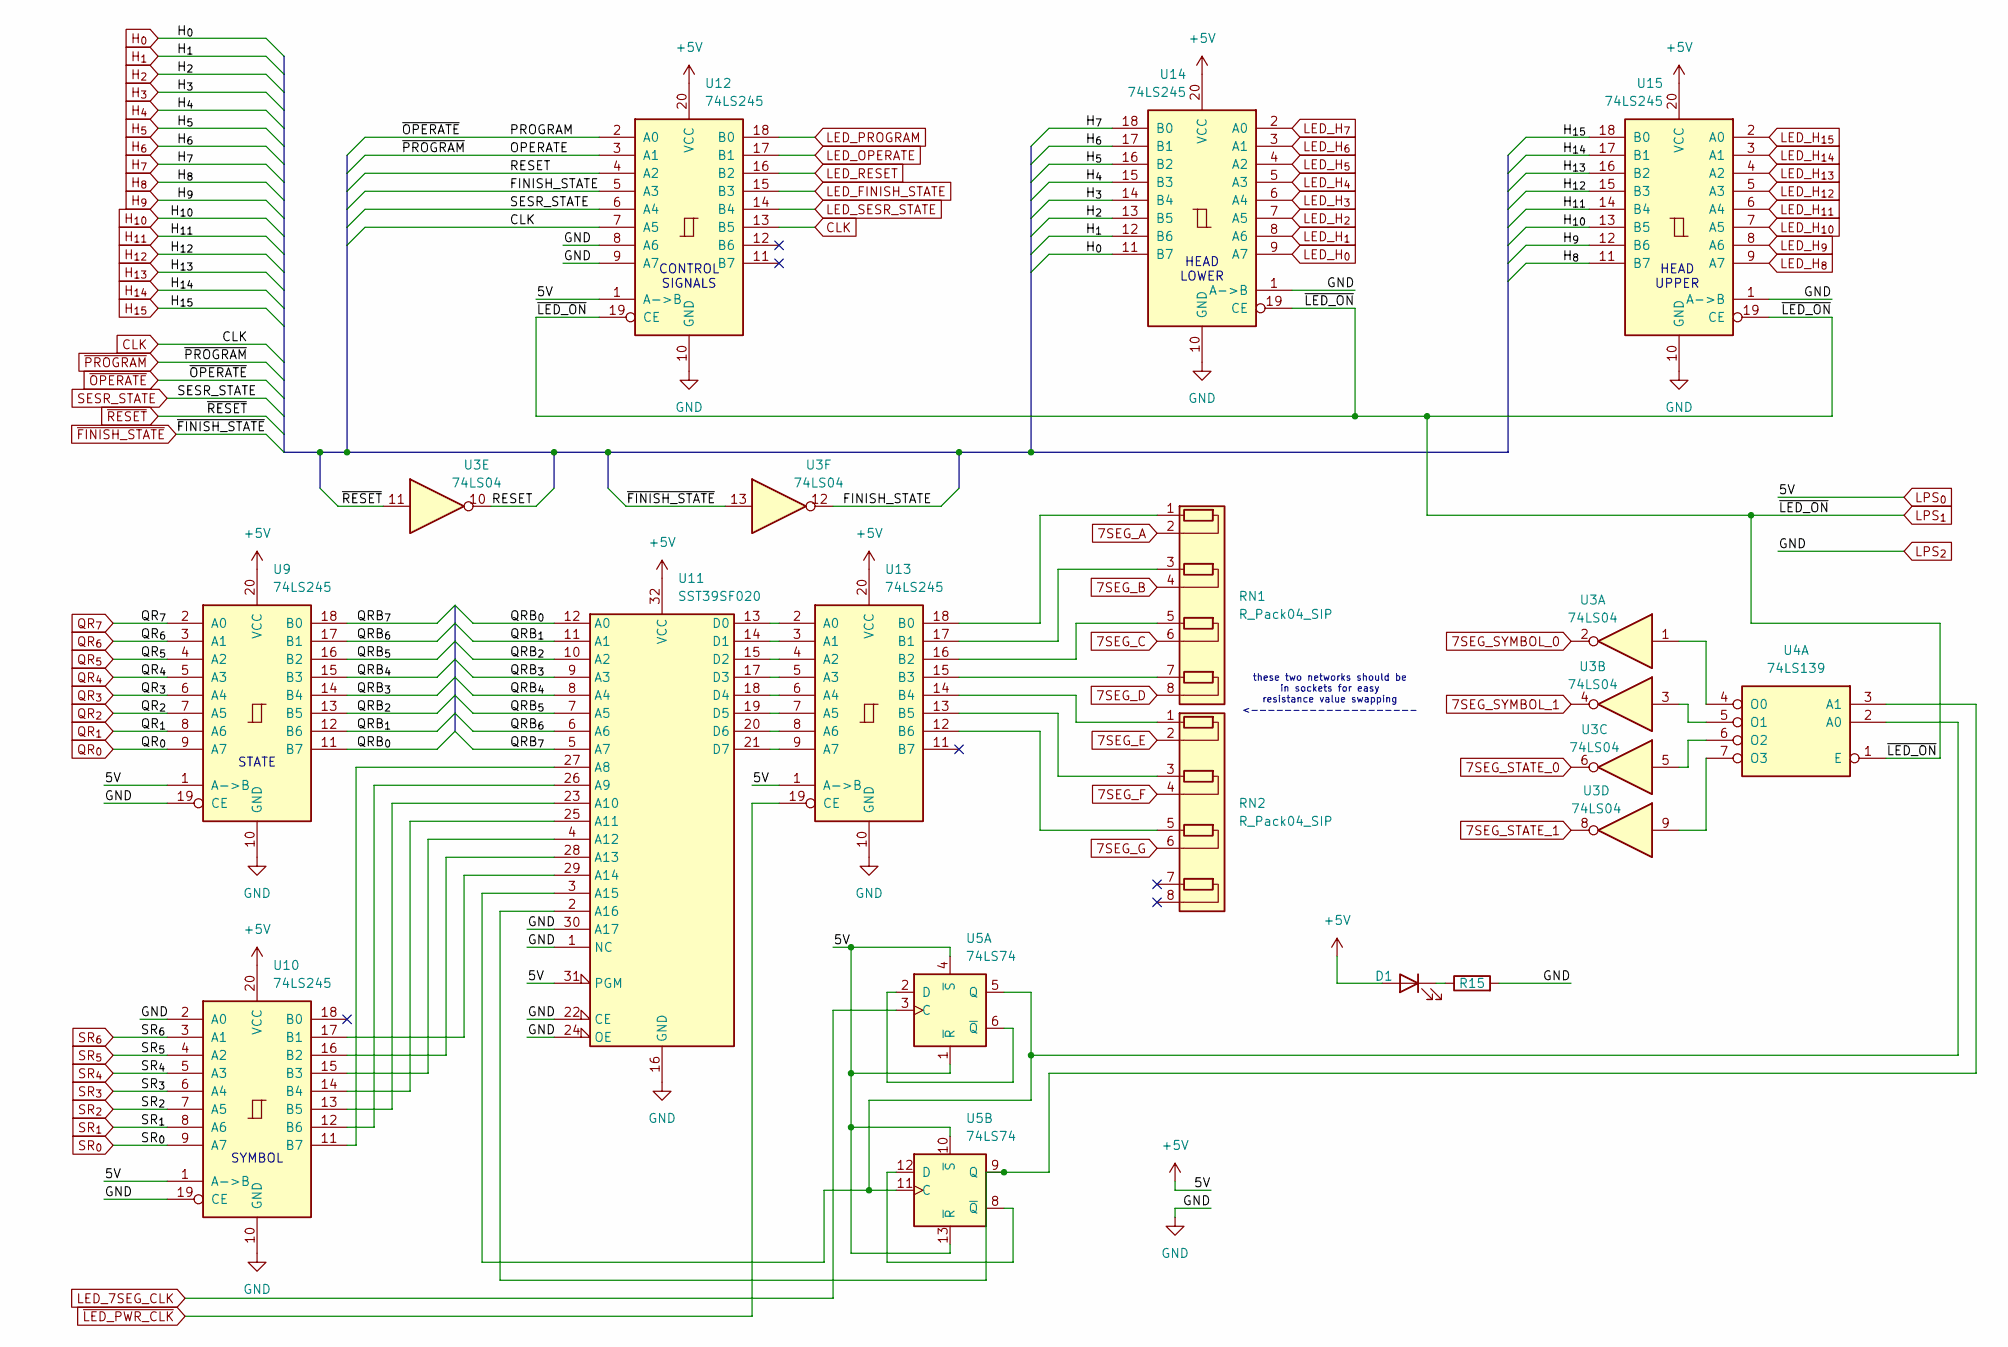
[picture p9: schematic led.kicad_sch]

Parts:
D1: LED_POWER_R; LED_D5.0mm
R15: 330Ω; R_Axial_DIN0207_L6.3mm_D2.5mm_P10.16mm_Horizontal
RN1, RN2: R_Pack04_SIP; R_Array_SIP8
U3: 74LS04; DIP-14_W7.62mm
U4: 74LS139; DIP-16_W7.62mm
U5: 74LS74; DIP-14_W7.62mm
U9, U10, U12, U13, U14, U15: 74LS245; DIP-20_W7.62mm
U11: SST39SF020; DIP-32_W15.24mm

Connections:
7SEG_A: RN1.2 (R1.2); also elsewhere on the board
7SEG_B: RN1.4 (R2.2); also elsewhere on the board
7SEG_C: RN1.6 (R3.2); also elsewhere on the board
7SEG_D: RN1.8 (R4.2); also elsewhere on the board
7SEG_E: RN2.2 (R1.2); also elsewhere on the board
7SEG_F: RN2.4 (R2.2); also elsewhere on the board
7SEG_G: RN2.6 (R3.2); also elsewhere on the board
7SEG_STATE_0: U3.6; also elsewhere on the board
7SEG_STATE_1: U3.8; also elsewhere on the board
7SEG_SYMBOL_0: U3.2; also elsewhere on the board
7SEG_SYMBOL_1: U3.4; also elsewhere on the board
/LED display/FINISH_STATE: U3.12, U12.5 (A3)
/LED display/QRB_{0}: U9.11 (B7), U11.12 (A0)
/LED display/QRB_{1}: U9.12 (B6), U11.11 (A1)
/LED display/QRB_{2}: U9.13 (B5), U11.10 (A2)
/LED display/QRB_{3}: U9.14 (B4), U11.9 (A3)
/LED display/QRB_{4}: U9.15 (B3), U11.8 (A4)
/LED display/QRB_{5}: U9.16 (B2), U11.7 (A5)
/LED display/QRB_{6}: U9.17 (B1), U11.6 (A6)
/LED display/QRB_{7}: U9.18 (B0), U11.5 (A7)
/LED display/RESET: U3.10, U12.4 (A2)
CLK: U12.7 (A5), U12.13 (B5); also elsewhere on the board
H_{0}: U14.11 (B7); also elsewhere on the board
H_{1}: U14.12 (B6); also elsewhere on the board
H_{2}: U14.13 (B5); also elsewhere on the board
H_{3}: U14.14 (B4); also elsewhere on the board
H_{4}: U14.15 (B3); also elsewhere on the board
H_{5}: U14.16 (B2); also elsewhere on the board
H_{6}: U14.17 (B1); also elsewhere on the board
H_{7}: U14.18 (B0); also elsewhere on the board
H_{8}: U15.11 (B7); also elsewhere on the board
H_{9}: U15.12 (B6); also elsewhere on the board
H_{10}: U15.13 (B5); also elsewhere on the board
H_{11}: U15.14 (B4); also elsewhere on the board
H_{12}: U15.15 (B3); also elsewhere on the board
H_{13}: U15.16 (B2); also elsewhere on the board
H_{14}: U15.17 (B1); also elsewhere on the board
H_{15}: U15.18 (B0); also elsewhere on the board
LED_7SEG_CLK: U5.3 (C); also elsewhere on the board
LED_FINISH_STATE: U12.15 (B3); also elsewhere on the board
LED_H_{0}: U14.9 (A7); also elsewhere on the board
LED_H_{1}: U14.8 (A6); also elsewhere on the board
LED_H_{2}: U14.7 (A5); also elsewhere on the board
LED_H_{3}: U14.6 (A4); also elsewhere on the board
LED_H_{4}: U14.5 (A3); also elsewhere on the board
LED_H_{5}: U14.4 (A2); also elsewhere on the board
LED_H_{6}: U14.3 (A1); also elsewhere on the board
LED_H_{7}: U14.2 (A0); also elsewhere on the board
LED_H_{8}: U15.9 (A7); also elsewhere on the board
LED_H_{9}: U15.8 (A6); also elsewhere on the board
LED_H_{10}: U15.7 (A5); also elsewhere on the board
LED_H_{11}: U15.6 (A4); also elsewhere on the board
LED_H_{12}: U15.5 (A3); also elsewhere on the board
LED_H_{13}: U15.4 (A2); also elsewhere on the board
LED_H_{14}: U15.3 (A1); also elsewhere on the board
LED_H_{15}: U15.2 (A0); also elsewhere on the board
LED_OPERATE: U12.17 (B1); also elsewhere on the board
LED_PROGRAM: U12.18 (B0); also elsewhere on the board
LED_RESET: U12.16 (B2); also elsewhere on the board
LED_SESR_STATE: U12.14 (B4); also elsewhere on the board
LPS_{0}: D1.2 (A), U5.1 (~R), U5.4 (~S), U5.10 (~S), U5.13 (~R), U9.1 (A->B), U9.20 (VCC), U10.1 (A->B), U10.20 (VCC), U11.31 (PGM), U11.32 (VCC), U12.1 (A->B), U12.20 (VCC), U13.1 (A->B), U13.20 (VCC), U14.20 (VCC), U15.20 (VCC); also elsewhere on the board
LPS_{1}: U4.1 (E), U12.19 (CE), U14.19 (CE), U15.19 (CE); also elsewhere on the board
unnamed: D1.1 (K), R15.1
unnamed: RN1.1 (R1.1), U13.18 (B0)
unnamed: RN1.3 (R2.1), U13.17 (B1)
unnamed: RN1.5 (R3.1), U13.16 (B2)
unnamed: RN1.7 (R4.1), U13.15 (B3)
unnamed: RN2.1 (R1.1), U13.14 (B4)
unnamed: RN2.3 (R2.1), U13.13 (B5)
unnamed: RN2.5 (R3.1), U13.12 (B6)
unnamed: U3.1, U4.4 (O0)
unnamed: U3.3, U4.5 (O1)
unnamed: U3.5, U4.6 (O2)
unnamed: U3.9, U4.7 (O3)
unnamed: U5.2 (D), U5.6 (~Q)
unnamed: U5.8 (~Q), U5.12 (D)
unnamed: U10.17 (B1), U11.29 (A14)
unnamed: U10.16 (B2), U11.28 (A13)
unnamed: U10.15 (B3), U11.4 (A12)
unnamed: U10.14 (B4), U11.25 (A11)
unnamed: U10.13 (B5), U11.23 (A10)
unnamed: U10.12 (B6), U11.26 (A9)
unnamed: U10.11 (B7), U11.27 (A8)
unnamed: U4.2 (A0), U5.5 (Q), U5.11 (C), U11.3 (A15)
unnamed: U4.3 (A1), U5.9 (Q), U11.2 (A16)
unnamed: U11.13 (D0), U13.2 (A0)
unnamed: U11.14 (D1), U13.3 (A1)
unnamed: U11.15 (D2), U13.4 (A2)
unnamed: U11.17 (D3), U13.5 (A3)
unnamed: U11.18 (D4), U13.6 (A4)
unnamed: U11.19 (D5), U13.7 (A5)
unnamed: U11.20 (D6), U13.8 (A6)
unnamed: U11.21 (D7), U13.9 (A7)
QR_{0}: U9.9 (A7); also elsewhere on the board
QR_{1}: U9.8 (A6); also elsewhere on the board
QR_{2}: U9.7 (A5); also elsewhere on the board
QR_{3}: U9.6 (A4); also elsewhere on the board
QR_{4}: U9.5 (A3); also elsewhere on the board
QR_{5}: U9.4 (A2); also elsewhere on the board
QR_{6}: U9.3 (A1); also elsewhere on the board
QR_{7}: U9.2 (A0); also elsewhere on the board
RRB_{1}: R15.2, U9.10 (GND), U9.19 (CE), U10.2 (A0), U10.10 (GND), U10.19 (CE), U11.1 (NC), U11.16 (GND), U11.22 (CE), U11.24 (OE), U11.30 (A17), U12.8 (A6), U12.9 (A7), U12.10 (GND), U13.10 (GND), U14.1 (A->B), U14.10 (GND), U15.1 (A->B), U15.10 (GND); also elsewhere on the board
SESR_STATE: U12.6 (A4); also elsewhere on the board
SR_{0}: U10.9 (A7); also elsewhere on the board
SR_{1}: U10.8 (A6); also elsewhere on the board
SR_{2}: U10.7 (A5); also elsewhere on the board
SR_{3}: U10.6 (A4); also elsewhere on the board
SR_{4}: U10.5 (A3); also elsewhere on the board
SR_{5}: U10.4 (A2); also elsewhere on the board
SR_{6}: U10.3 (A1); also elsewhere on the board
~FINISH_STATE: U3.13; also elsewhere on the board
~LED_PWR_CLK: U13.19 (CE); also elsewhere on the board
~OPERATE: U12.2 (A0); also elsewhere on the board
~PROGRAM: U12.3 (A1); also elsewhere on the board
~RESET: U3.11; also elsewhere on the board

Notes on the sheet:
HEAD UPPER
SYMBOL
CONTROL SIGNALS
these two networks should be in sockets for easy resistance value swapping <--------------------
HEAD LOWER
STATE

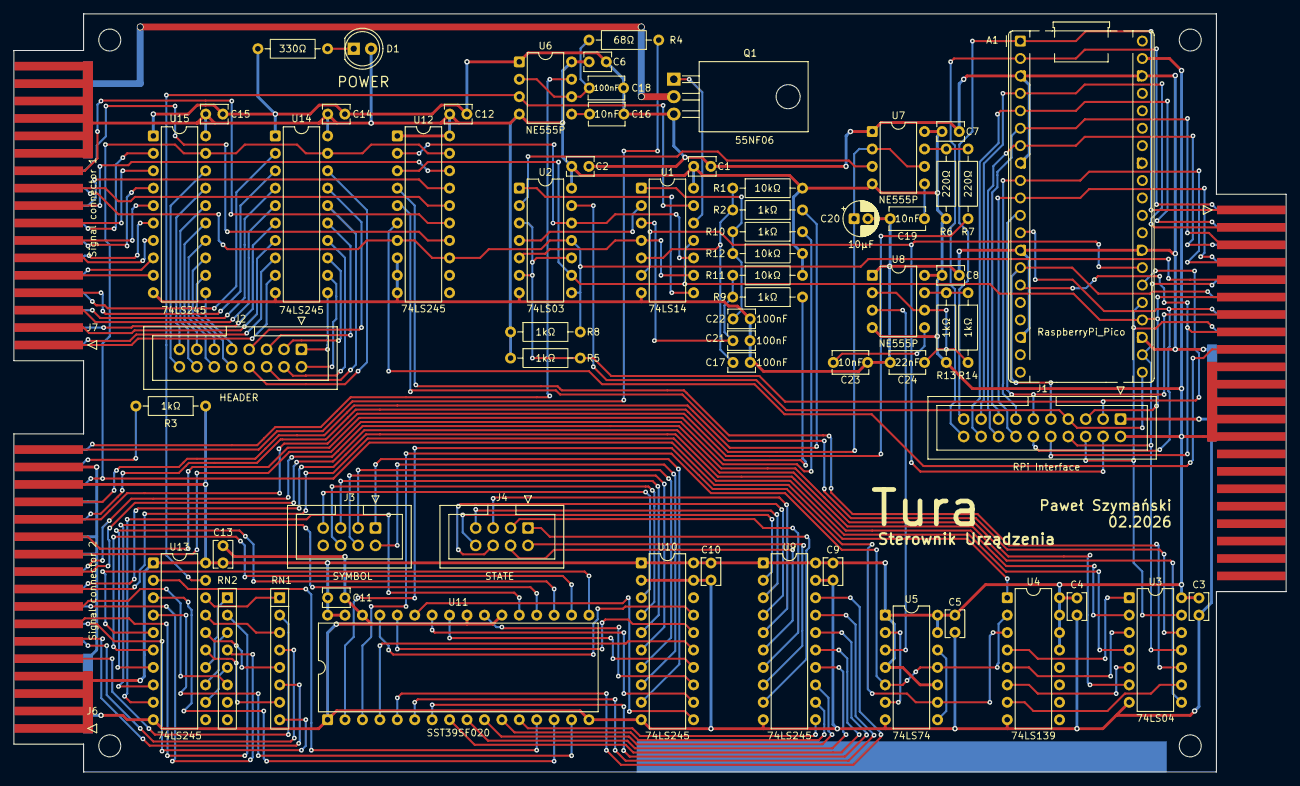
[picture p10: board turing_driver.kicad_pcb from above]

Board: 2 copper layers, 185.4 x 110.5 mm, 66 parts (0 on the bottom side), 154 nets.
