szymanp135/Tura/backplane/backplane.kicad_pcb

## KiCad design backplane/backplane.kicad_pcb (2026-03-20)

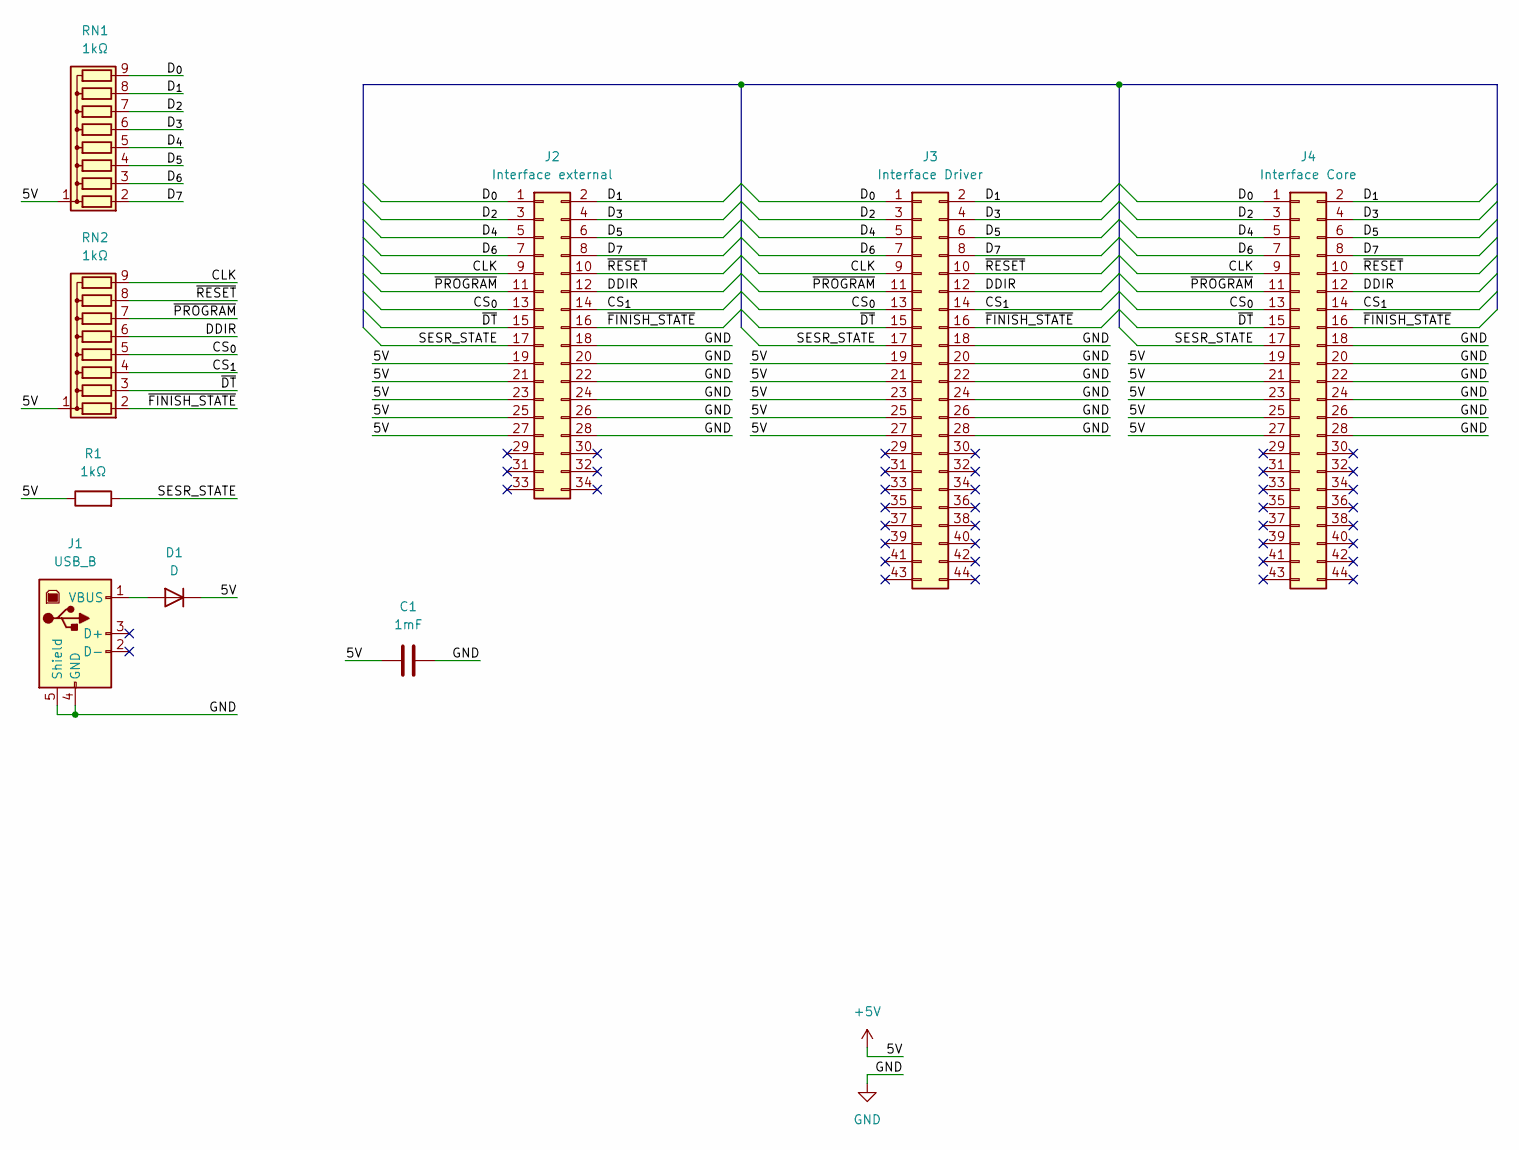
[picture p11: schematic backplane.kicad_sch]

Parts:
C1: 1mF; C_Radial_D12.5mm_H20.0mm_P5.00mm
D1: D; D_DO-35_SOD27_P10.16mm_Horizontal
J1: USB_B; USB_B_OST_USB-B1HSxx_Horizontal
J2: Interface external; IDC-Header_2x17_P2.54mm_Vertical
J3: Interface Driver; Connector_IDC_Edge_2x22pin_odd
J4: Interface Core; Connector_IDC_Edge_2x22pin_odd
R1: 1kΩ
RN1, RN2: 1kΩ; R_Array_SIP9

Connections:
+5V: C1.1, D1.1 (K), J2.19, J2.21, J2.23, J2.25, J2.27, J3.19, J3.21, J3.23, J3.25, J3.27, J4.19, J4.21, J4.23, J4.25, J4.27, R1.1, RN1.1 (common), RN2.1 (common)
/CLK: J2.9, J3.9, J4.9, RN2.9 (R8)
/CS_{0}: J2.13, J3.13, J4.13, RN2.5 (R4)
/CS_{1}: J2.14, J3.14, J4.14, RN2.4 (R3)
/DDIR: J2.12, J3.12, J4.12, RN2.6 (R5)
/D_{0}: J2.1, J3.1, J4.1, RN1.9 (R8)
/D_{1}: J2.2, J3.2, J4.2, RN1.8 (R7)
/D_{2}: J2.3, J3.3, J4.3, RN1.7 (R6)
/D_{3}: J2.4, J3.4, J4.4, RN1.6 (R5)
/D_{4}: J2.5, J3.5, J4.5, RN1.5 (R4)
/D_{5}: J2.6, J3.6, J4.6, RN1.4 (R3)
/D_{6}: J2.7, J3.7, J4.7, RN1.3 (R2)
/D_{7}: J2.8, J3.8, J4.8, RN1.2 (R1)
/SESR_STATE: J2.17, J3.17, J4.17, R1.2
/~DT: J2.15, J3.15, J4.15, RN2.3 (R2)
/~FINISH_STATE: J2.16, J3.16, J4.16, RN2.2 (R1)
/~PROGRAM: J2.11, J3.11, J4.11, RN2.7 (R6)
/~RESET: J2.10, J3.10, J4.10, RN2.8 (R7)
GND: C1.2, J1.4 (GND), J1.5 (Shield), J2.18, J2.20, J2.22, J2.24, J2.26, J2.28, J3.18, J3.20, J3.22, J3.24, J3.26, J3.28, J4.18, J4.20, J4.22, J4.24, J4.26, J4.28
unnamed: D1.2 (A), J1.1 (VBUS)

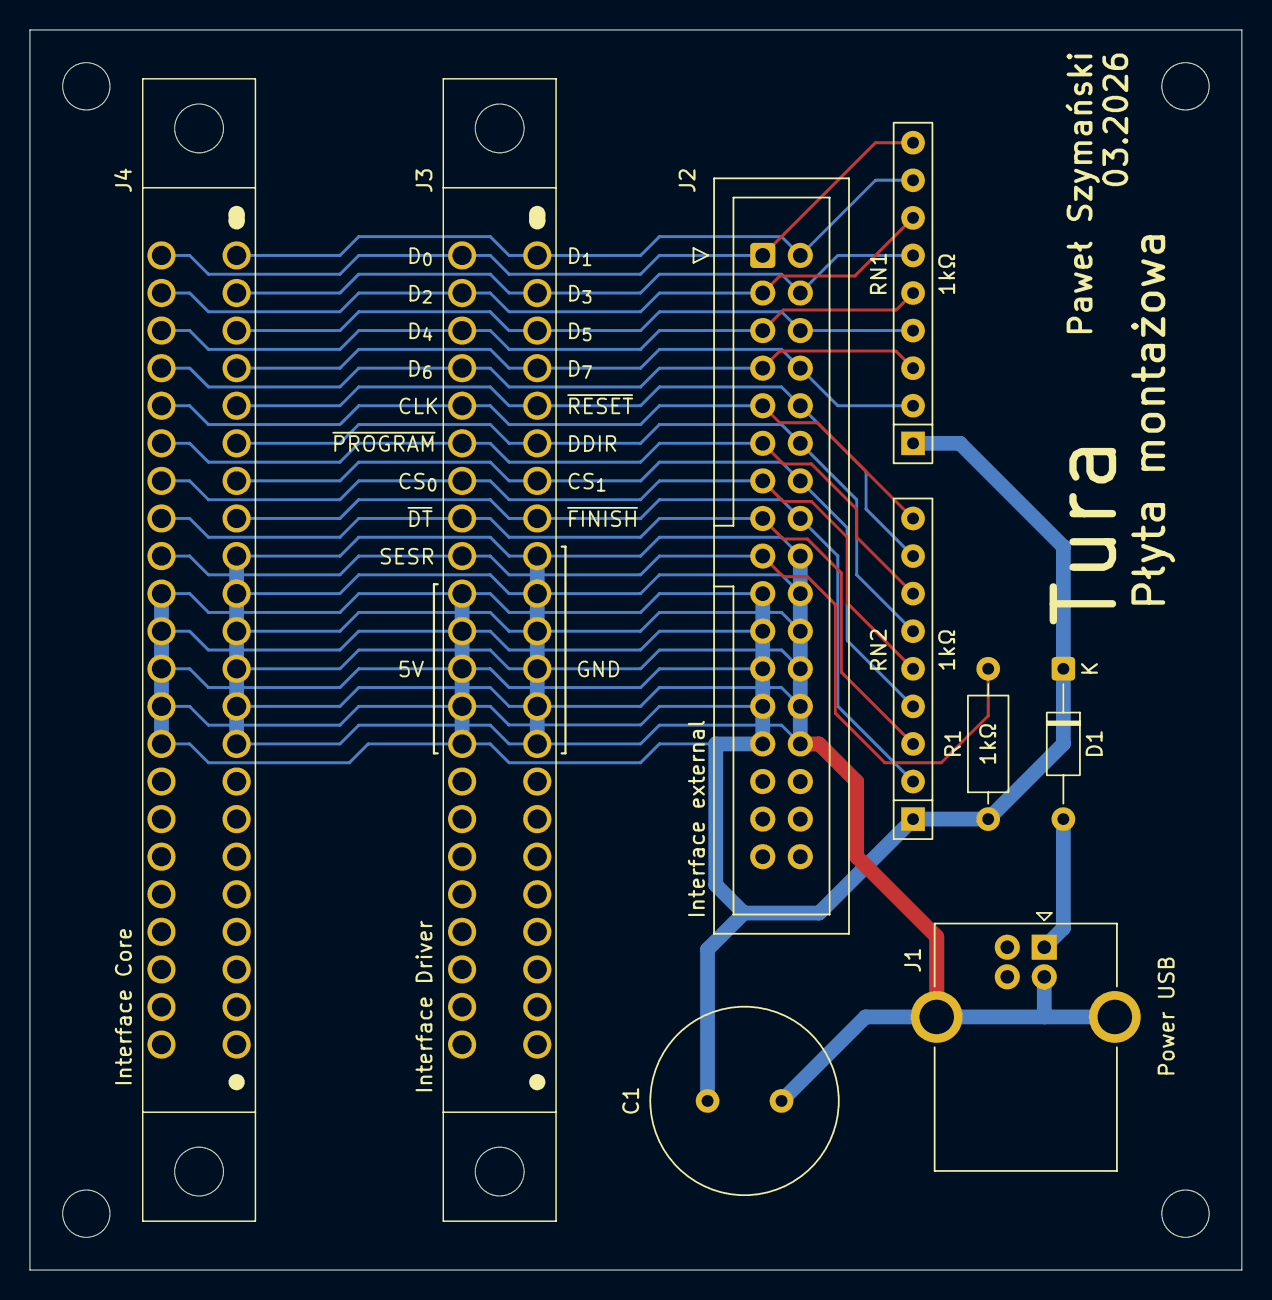
[picture p12: board backplane.kicad_pcb from above]

Board: 2 copper layers, 81.9 x 83.8 mm, 9 parts (0 on the bottom side), 20 nets.
