szymanp135/Tura/turing_machine_core/turing_machine.kicad_pcb

## KiCad design turing_machine_core/turing_machine.kicad_pcb (2026-03-20)

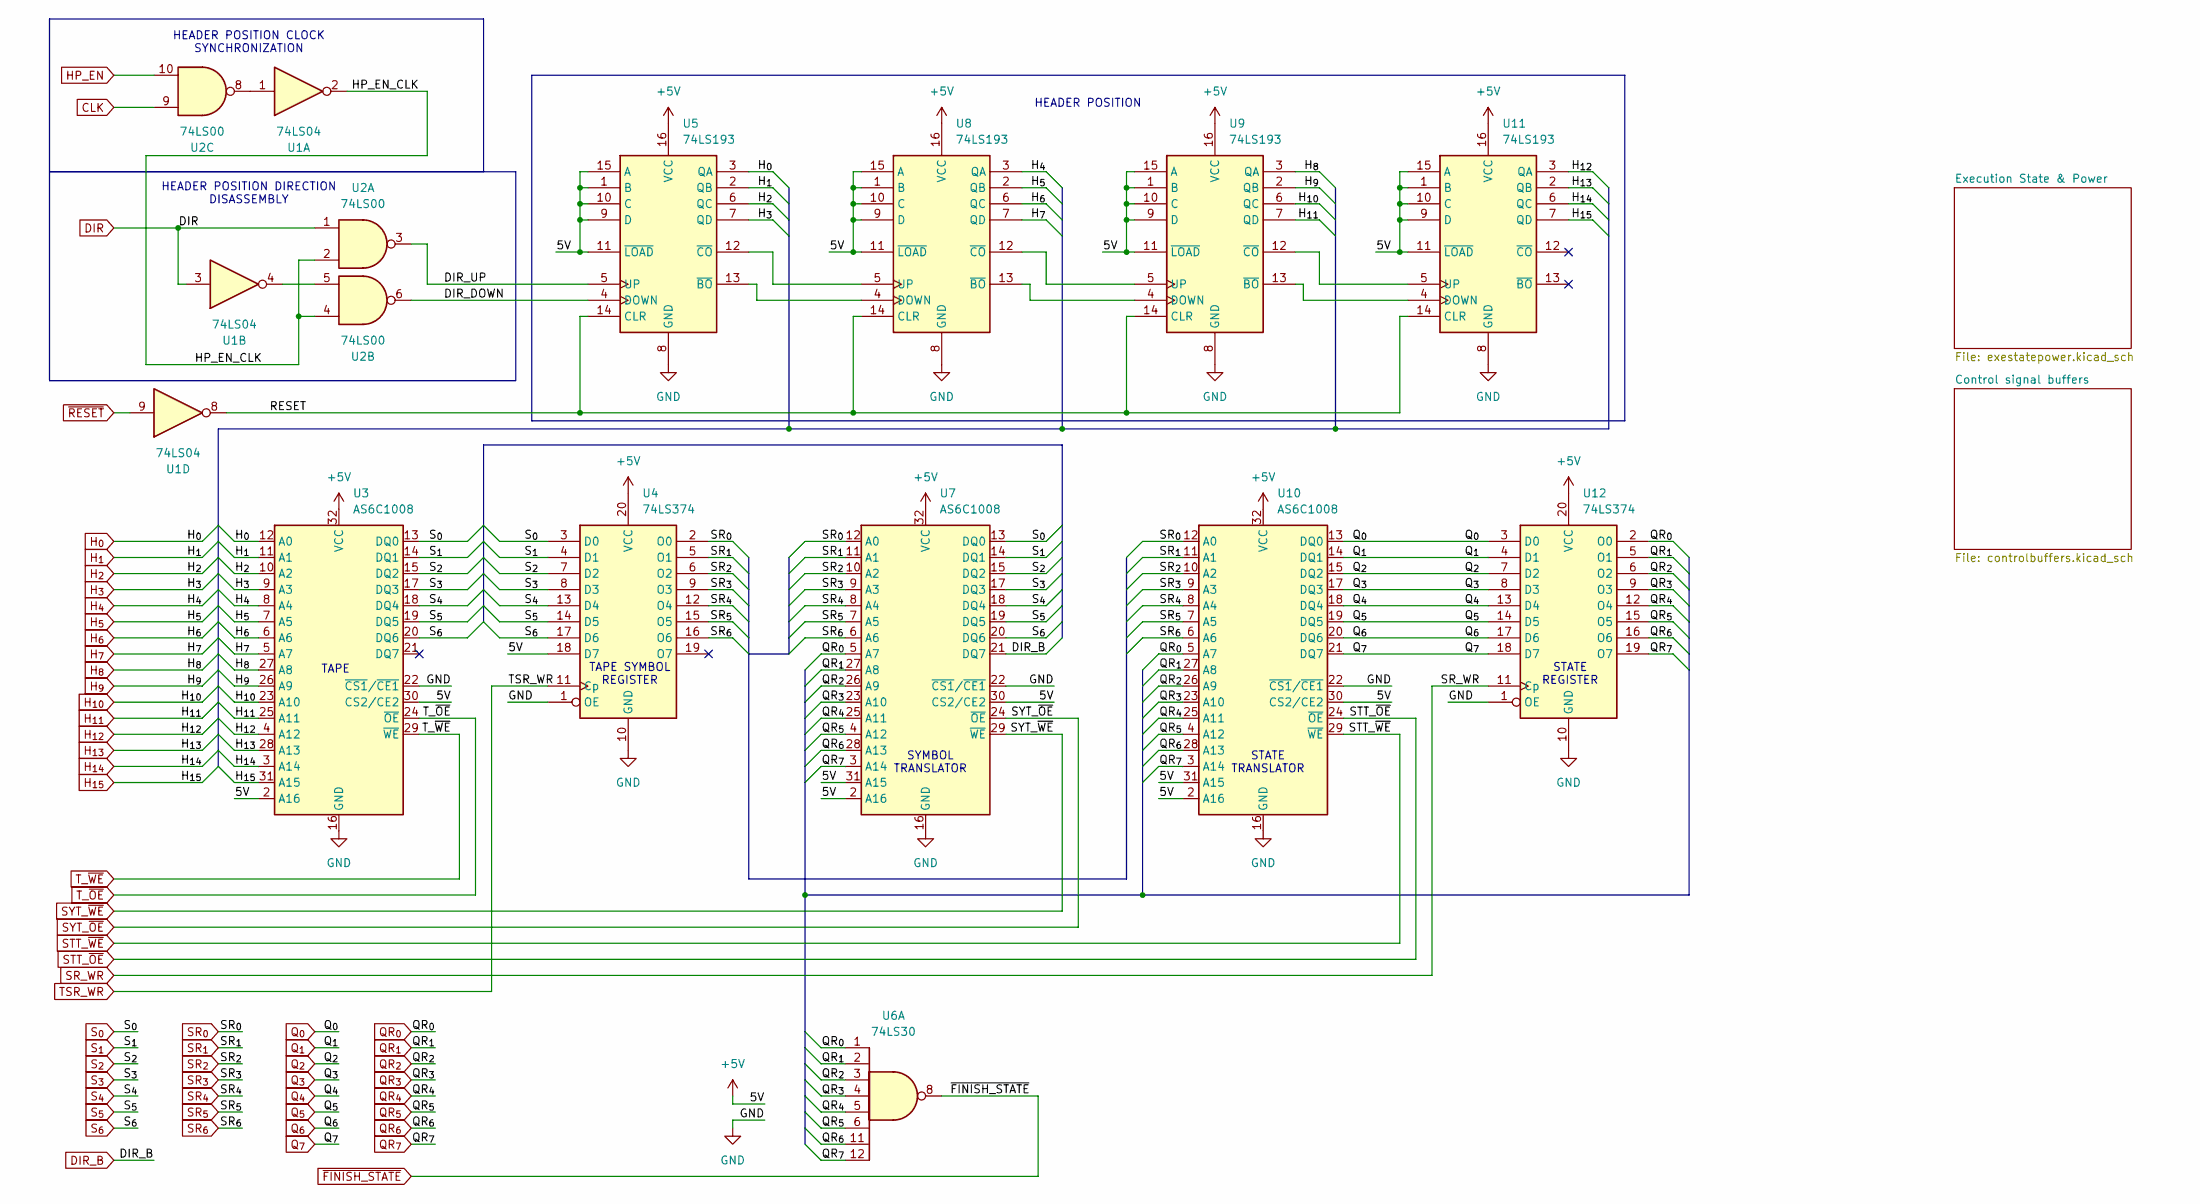
[picture p13: schematic turing_machine.kicad_sch]

Parts:
U1: 74LS04; DIP-14_W7.62mm
U2: 74LS00; DIP-14_W7.62mm
U3, U7, U10: AS6C1008; DIP-32_W15.24mm
U4, U12: 74LS374; DIP-20_W7.62mm
U5, U8, U9, U11: 74LS193; DIP-16_W7.62mm
U6: 74LS30; DIP-14_W7.62mm

Connections:
+5V: U3.2 (A16), U3.30 (CS2/CE2), U3.32 (VCC), U4.18 (D7), U4.20 (VCC), U5.1 (B), U5.9 (D), U5.10 (C), U5.11 (~LOAD), U5.15 (A), U5.16 (VCC), U7.2 (A16), U7.30 (CS2/CE2), U7.31 (A15), U7.32 (VCC), U8.1 (B), U8.9 (D), U8.10 (C), U8.11 (~LOAD), U8.15 (A), U8.16 (VCC), U9.1 (B), U9.9 (D), U9.10 (C), U9.11 (~LOAD), U9.15 (A), U9.16 (VCC), U10.2 (A16), U10.30 (CS2/CE2), U10.31 (A15), U10.32 (VCC), U11.1 (B), U11.9 (D), U11.10 (C), U11.11 (~LOAD), U11.15 (A), U11.16 (VCC), U12.20 (VCC); also elsewhere on the board
/DIR_DOWN: U2.6, U5.4 (DOWN)
/DIR_UP: U2.3, U5.5 (UP)
/HP_EN_CLK: U1.2, U2.2, U2.4
/RESET: U1.8, U5.14 (CLR), U8.14 (CLR), U9.14 (CLR), U11.14 (CLR)
CLK: U2.9; also elsewhere on the board
DIR: U1.3, U2.1; also elsewhere on the board
DIR_B: U7.21 (DQ7); also elsewhere on the board
GND: U3.16 (GND), U3.22 (~CS1/~CE1), U4.1 (OE), U4.10 (GND), U5.8 (GND), U7.16 (GND), U7.22 (~CS1/~CE1), U8.8 (GND), U9.8 (GND), U10.16 (GND), U10.22 (~CS1/~CE1), U11.8 (GND), U12.1 (OE), U12.10 (GND); also elsewhere on the board
HP_EN: U2.10, U4.11 (Cp); also elsewhere on the board
H_{0}: U3.12 (A0), U5.3 (QA); also elsewhere on the board
H_{1}: U3.11 (A1), U5.2 (QB); also elsewhere on the board
H_{2}: U3.10 (A2), U5.6 (QC); also elsewhere on the board
H_{3}: U3.9 (A3), U5.7 (QD); also elsewhere on the board
H_{4}: U3.8 (A4), U8.3 (QA); also elsewhere on the board
H_{5}: U3.7 (A5), U8.2 (QB); also elsewhere on the board
H_{6}: U3.6 (A6), U8.6 (QC); also elsewhere on the board
H_{7}: U3.5 (A7), U8.7 (QD); also elsewhere on the board
H_{8}: U3.27 (A8), U9.3 (QA); also elsewhere on the board
H_{9}: U3.26 (A9), U9.2 (QB); also elsewhere on the board
H_{10}: U3.23 (A10), U9.6 (QC); also elsewhere on the board
H_{11}: U3.25 (A11), U9.7 (QD); also elsewhere on the board
H_{12}: U3.4 (A12), U11.3 (QA); also elsewhere on the board
H_{13}: U3.28 (A13), U11.2 (QB); also elsewhere on the board
H_{14}: U3.3 (A14), U11.6 (QC); also elsewhere on the board
H_{15}: U3.31 (A15), U11.7 (QD); also elsewhere on the board
unnamed: U1.1, U2.8
unnamed: U1.4, U2.5
unnamed: U5.13 (~BO), U8.4 (DOWN)
unnamed: U5.12 (~CO), U8.5 (UP)
unnamed: U8.13 (~BO), U9.4 (DOWN)
unnamed: U8.12 (~CO), U9.5 (UP)
unnamed: U9.13 (~BO), U11.4 (DOWN)
unnamed: U9.12 (~CO), U11.5 (UP)
QR_{0}: U6.1, U7.5 (A7), U10.5 (A7), U12.2 (O0); also elsewhere on the board
QR_{1}: U6.2, U7.27 (A8), U10.27 (A8), U12.5 (O1); also elsewhere on the board
QR_{2}: U6.3, U7.26 (A9), U10.26 (A9), U12.6 (O2); also elsewhere on the board
QR_{3}: U6.4, U7.23 (A10), U10.23 (A10), U12.9 (O3); also elsewhere on the board
QR_{4}: U6.5, U7.25 (A11), U10.25 (A11), U12.12 (O4); also elsewhere on the board
QR_{5}: U6.6, U7.4 (A12), U10.4 (A12), U12.15 (O5); also elsewhere on the board
QR_{6}: U6.11, U7.28 (A13), U10.28 (A13), U12.16 (O6); also elsewhere on the board
QR_{7}: U6.12, U7.3 (A14), U10.3 (A14), U12.19 (O7); also elsewhere on the board
Q_{0}: U10.13 (DQ0), U12.3 (D0); also elsewhere on the board
Q_{1}: U10.14 (DQ1), U12.4 (D1); also elsewhere on the board
Q_{2}: U10.15 (DQ2), U12.7 (D2); also elsewhere on the board
Q_{3}: U10.17 (DQ3), U12.8 (D3); also elsewhere on the board
Q_{4}: U10.18 (DQ4), U12.13 (D4); also elsewhere on the board
Q_{5}: U10.19 (DQ5), U12.14 (D5); also elsewhere on the board
Q_{6}: U10.20 (DQ6), U12.17 (D6); also elsewhere on the board
Q_{7}: U10.21 (DQ7), U12.18 (D7); also elsewhere on the board
SR_WR: U12.11 (Cp); also elsewhere on the board
SR_{0}: U4.2 (O0), U7.12 (A0), U10.12 (A0); also elsewhere on the board
SR_{1}: U4.5 (O1), U7.11 (A1), U10.11 (A1); also elsewhere on the board
SR_{2}: U4.6 (O2), U7.10 (A2), U10.10 (A2); also elsewhere on the board
SR_{3}: U4.9 (O3), U7.9 (A3), U10.9 (A3); also elsewhere on the board
SR_{4}: U4.12 (O4), U7.8 (A4), U10.8 (A4); also elsewhere on the board
SR_{5}: U4.15 (O5), U7.7 (A5), U10.7 (A5); also elsewhere on the board
SR_{6}: U4.16 (O6), U7.6 (A6), U10.6 (A6); also elsewhere on the board
STT_~OE: U10.24 (~OE); also elsewhere on the board
STT_~WE: U10.29 (~WE); also elsewhere on the board
SYT_~OE: U7.24 (~OE); also elsewhere on the board
SYT_~WE: U7.29 (~WE); also elsewhere on the board
S_{0}: U3.13 (DQ0), U4.3 (D0), U7.13 (DQ0); also elsewhere on the board
S_{1}: U3.14 (DQ1), U4.4 (D1), U7.14 (DQ1); also elsewhere on the board
S_{2}: U3.15 (DQ2), U4.7 (D2), U7.15 (DQ2); also elsewhere on the board
S_{3}: U3.17 (DQ3), U4.8 (D3), U7.17 (DQ3); also elsewhere on the board
S_{4}: U3.18 (DQ4), U4.13 (D4), U7.18 (DQ4); also elsewhere on the board
S_{5}: U3.19 (DQ5), U4.14 (D5), U7.19 (DQ5); also elsewhere on the board
S_{6}: U3.20 (DQ6), U4.17 (D6), U7.20 (DQ6); also elsewhere on the board
T_~OE: U3.24 (~OE); also elsewhere on the board
T_~WE: U3.29 (~WE); also elsewhere on the board
~FINISH_STATE: U6.8; also elsewhere on the board
~RESET: U1.9; also elsewhere on the board

Notes on the sheet:
HEADER POSITION DIRECTION DISASSEMBLY
HEADER POSITION CLOCK SYNCHRONIZATION
STATE TRANSLATOR
TAPE SYMBOL REGISTER
HEADER POSITION
TAPE
STATE REGISTER
SYMBOL TRANSLATOR

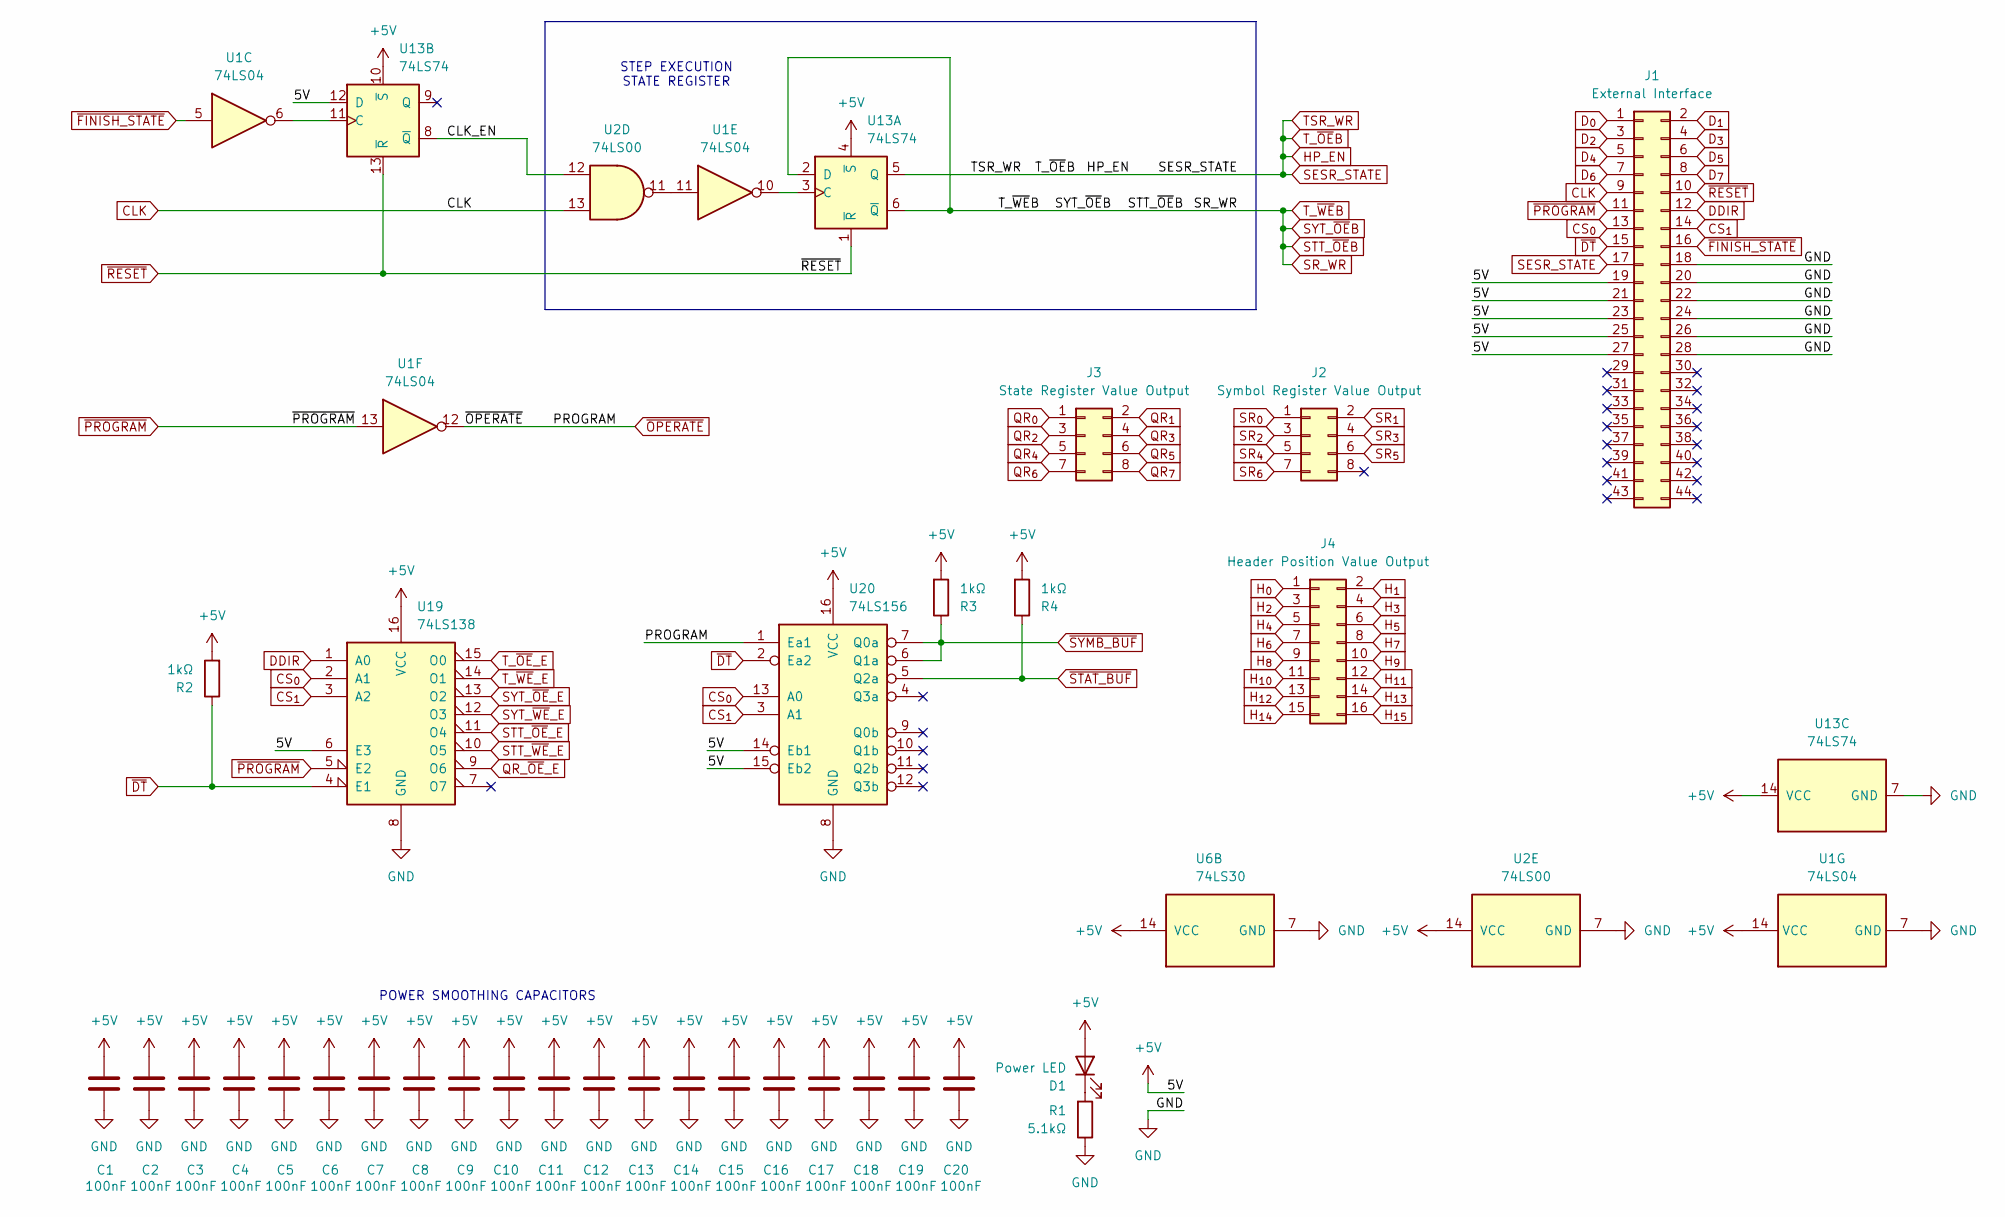
[picture p14: schematic exestatepower.kicad_sch]

Parts:
C1, C2, C3, C4, C5, C6, C7, C8, C9, C10, C11, C12, C13, C14, C15, C16, C17, C18, C19, C20: 100nF; C_Disc_D3.8mm_W2.6mm_P2.50mm
D1: Power LED; LED_D5.0mm
J1: External Interface; Connector_Edge_2x22pin_odd
J2: Symbol Register Value Output; PinHeader_2x04_P2.54mm_Vertical
J3: State Register Value Output; PinHeader_2x04_P2.54mm_Vertical
J4: Header Position Value Output; PinHeader_2x08_P2.54mm_Vertical
R1: 5.1kΩ; R_Axial_DIN0207_L6.3mm_D2.5mm_P10.16mm_Horizontal
R2, R3, R4: 1kΩ; R_Axial_DIN0207_L6.3mm_D2.5mm_P10.16mm_Horizontal
U1: 74LS04; DIP-14_W7.62mm
U2: 74LS00; DIP-14_W7.62mm
U6: 74LS30; DIP-14_W7.62mm
U13: 74LS74; DIP-14_W7.62mm
U19: 74LS138; DIP-16_W7.62mm
U20: 74LS156; DIP-16_W7.62mm

Connections:
+5V: C1.1, C2.1, C3.1, C4.1, C5.1, C6.1, C7.1, C8.1, C9.1, C10.1, C11.1, C12.1, C13.1, C14.1, C15.1, C16.1, C17.1, C18.1, C19.1, C20.1, D1.2 (A), J1.19, J1.21, J1.23, J1.25, J1.27, R2.2, R3.2, R4.2, U1.14 (VCC), U2.14 (VCC), U6.14 (VCC), U13.4 (~S), U13.10 (~S), U13.12 (D), U13.14 (VCC), U19.6 (E3), U19.16 (VCC), U20.14 (Eb1), U20.15 (Eb2), U20.16 (VCC); also elsewhere on the board
/Execution State & Power/CLK_EN: U2.12, U13.8 (~Q)
CLK: J1.9, U2.13; also elsewhere on the board
CS_{0}: J1.13, U19.2 (A1), U20.13 (A0)
CS_{1}: J1.14, U19.3 (A2), U20.3 (A1)
DDIR: J1.12, U19.1 (A0); also elsewhere on the board
D_{0}: J1.1; also elsewhere on the board
D_{1}: J1.2; also elsewhere on the board
D_{2}: J1.3; also elsewhere on the board
D_{3}: J1.4; also elsewhere on the board
D_{4}: J1.5; also elsewhere on the board
D_{5}: J1.6; also elsewhere on the board
D_{6}: J1.7; also elsewhere on the board
D_{7}: J1.8; also elsewhere on the board
GND: C1.2, C2.2, C3.2, C4.2, C5.2, C6.2, C7.2, C8.2, C9.2, C10.2, C11.2, C12.2, C13.2, C14.2, C15.2, C16.2, C17.2, C18.2, C19.2, C20.2, J1.18, J1.20, J1.22, J1.24, J1.26, J1.28, R1.1, U1.7 (GND), U2.7 (GND), U6.7 (GND), U13.7 (GND), U19.8 (GND), U20.8 (GND); also elsewhere on the board
HP_EN: J1.17, U13.5 (Q); also elsewhere on the board
H_{0}: J4.1; also elsewhere on the board
H_{1}: J4.2; also elsewhere on the board
H_{2}: J4.3; also elsewhere on the board
H_{3}: J4.4; also elsewhere on the board
H_{4}: J4.5; also elsewhere on the board
H_{5}: J4.6; also elsewhere on the board
H_{6}: J4.7; also elsewhere on the board
H_{7}: J4.8; also elsewhere on the board
H_{8}: J4.9; also elsewhere on the board
H_{9}: J4.10; also elsewhere on the board
H_{10}: J4.11; also elsewhere on the board
H_{11}: J4.12; also elsewhere on the board
H_{12}: J4.13; also elsewhere on the board
H_{13}: J4.14; also elsewhere on the board
H_{14}: J4.15; also elsewhere on the board
H_{15}: J4.16; also elsewhere on the board
unnamed: D1.1 (K), R1.2
unnamed: U1.11, U2.11
unnamed: U1.10, U13.3 (C)
unnamed: U1.6, U13.11 (C)
QR_{0}: J3.1; also elsewhere on the board
QR_{1}: J3.2; also elsewhere on the board
QR_{2}: J3.3; also elsewhere on the board
QR_{3}: J3.4; also elsewhere on the board
QR_{4}: J3.5; also elsewhere on the board
QR_{5}: J3.6; also elsewhere on the board
QR_{6}: J3.7; also elsewhere on the board
QR_{7}: J3.8; also elsewhere on the board
QR_~OE_E: U19.9 (O6); also elsewhere on the board
SR_WR: U13.2 (D), U13.6 (~Q); also elsewhere on the board
SR_{0}: J2.1; also elsewhere on the board
SR_{1}: J2.2; also elsewhere on the board
SR_{2}: J2.3; also elsewhere on the board
SR_{3}: J2.4; also elsewhere on the board
SR_{4}: J2.5; also elsewhere on the board
SR_{5}: J2.6; also elsewhere on the board
SR_{6}: J2.7; also elsewhere on the board
STT_~OE_E: U19.11 (O4); also elsewhere on the board
STT_~WE_E: U19.10 (O5); also elsewhere on the board
SYT_~OE_E: U19.13 (O2); also elsewhere on the board
SYT_~WE_E: U19.12 (O3); also elsewhere on the board
T_~OE_E: U19.15 (O0); also elsewhere on the board
T_~WE_E: U19.14 (O1); also elsewhere on the board
~DT: J1.15, R2.1, U19.4 (E1), U20.2 (Ea2)
~FINISH_STATE: J1.16, U1.5; also elsewhere on the board
~OPERATE: U1.12, U20.1 (Ea1); also elsewhere on the board
~PROGRAM: J1.11, U1.13, U19.5 (E2); also elsewhere on the board
~RESET: J1.10, U13.1 (~R), U13.13 (~R); also elsewhere on the board
~STAT_BUF: R4.1, U20.5 (Q2a); also elsewhere on the board
~SYMB_BUF: R3.1, U20.6 (Q1a), U20.7 (Q0a); also elsewhere on the board

Notes on the sheet:
STEP EXECUTION STATE REGISTER
POWER SMOOTHING CAPACITORS

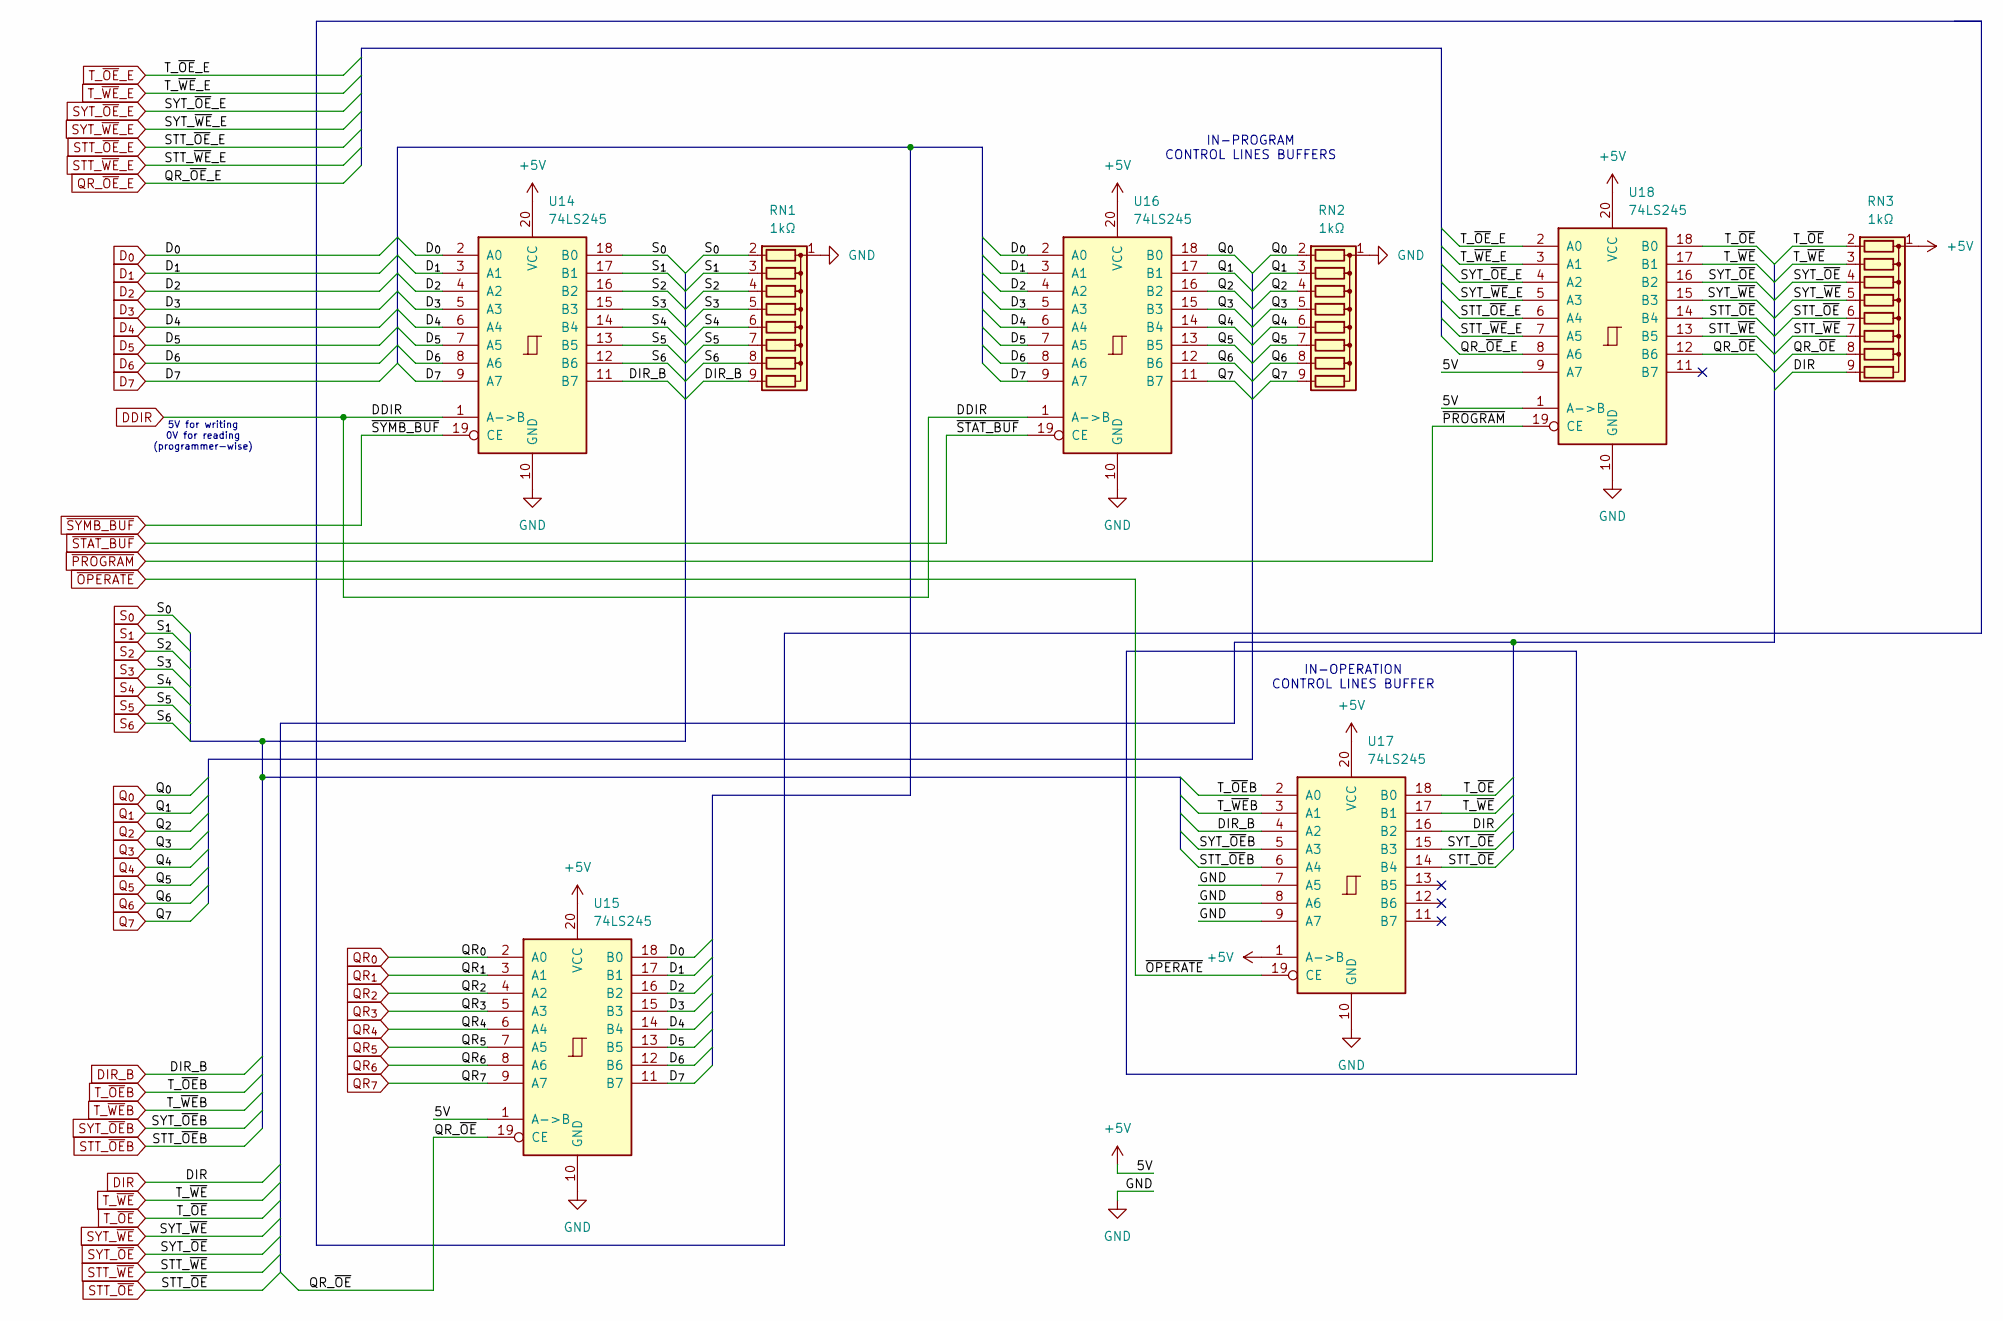
[picture p15: schematic controlbuffers.kicad_sch]

Parts:
RN1, RN2, RN3: 1kΩ; R_Array_SIP9
U14, U15, U16, U17, U18: 74LS245; DIP-20_W7.62mm

Connections:
+5V: RN3.1 (common), U14.20 (VCC), U15.1 (A->B), U15.20 (VCC), U16.20 (VCC), U17.1 (A->B), U17.20 (VCC), U18.1 (A->B), U18.9 (A7), U18.20 (VCC); also elsewhere on the board
/Control signal buffers/QR_~OE: RN3.8 (R7), U15.19 (CE), U18.12 (B6)
DDIR: U14.1 (A->B), U16.1 (A->B); also elsewhere on the board
DIR: RN3.9 (R8), U17.16 (B2); also elsewhere on the board
DIR_B: RN1.9 (R8), U14.11 (B7), U17.4 (A2); also elsewhere on the board
D_{0}: U14.2 (A0), U15.18 (B0), U16.2 (A0); also elsewhere on the board
D_{1}: U14.3 (A1), U15.17 (B1), U16.3 (A1); also elsewhere on the board
D_{2}: U14.4 (A2), U15.16 (B2), U16.4 (A2); also elsewhere on the board
D_{3}: U14.5 (A3), U15.15 (B3), U16.5 (A3); also elsewhere on the board
D_{4}: U14.6 (A4), U15.14 (B4), U16.6 (A4); also elsewhere on the board
D_{5}: U14.7 (A5), U15.13 (B5), U16.7 (A5); also elsewhere on the board
D_{6}: U14.8 (A6), U15.12 (B6), U16.8 (A6); also elsewhere on the board
D_{7}: U14.9 (A7), U15.11 (B7), U16.9 (A7); also elsewhere on the board
GND: RN1.1 (common), RN2.1 (common), U14.10 (GND), U15.10 (GND), U16.10 (GND), U17.7 (A5), U17.8 (A6), U17.9 (A7), U17.10 (GND), U18.10 (GND); also elsewhere on the board
HP_EN: U17.2 (A0); also elsewhere on the board
QR_{0}: U15.2 (A0); also elsewhere on the board
QR_{1}: U15.3 (A1); also elsewhere on the board
QR_{2}: U15.4 (A2); also elsewhere on the board
QR_{3}: U15.5 (A3); also elsewhere on the board
QR_{4}: U15.6 (A4); also elsewhere on the board
QR_{5}: U15.7 (A5); also elsewhere on the board
QR_{6}: U15.8 (A6); also elsewhere on the board
QR_{7}: U15.9 (A7); also elsewhere on the board
QR_~OE_E: U18.8 (A6); also elsewhere on the board
Q_{0}: RN2.2 (R1), U16.18 (B0); also elsewhere on the board
Q_{1}: RN2.3 (R2), U16.17 (B1); also elsewhere on the board
Q_{2}: RN2.4 (R3), U16.16 (B2); also elsewhere on the board
Q_{3}: RN2.5 (R4), U16.15 (B3); also elsewhere on the board
Q_{4}: RN2.6 (R5), U16.14 (B4); also elsewhere on the board
Q_{5}: RN2.7 (R6), U16.13 (B5); also elsewhere on the board
Q_{6}: RN2.8 (R7), U16.12 (B6); also elsewhere on the board
Q_{7}: RN2.9 (R8), U16.11 (B7); also elsewhere on the board
SR_WR: U17.3 (A1), U17.5 (A3), U17.6 (A4); also elsewhere on the board
STT_~OE: RN3.6 (R5), U17.14 (B4), U18.14 (B4); also elsewhere on the board
STT_~OE_E: U18.6 (A4); also elsewhere on the board
STT_~WE: RN3.7 (R6), U18.13 (B5); also elsewhere on the board
STT_~WE_E: U18.7 (A5); also elsewhere on the board
SYT_~OE: RN3.4 (R3), U17.15 (B3), U18.16 (B2); also elsewhere on the board
SYT_~OE_E: U18.4 (A2); also elsewhere on the board
SYT_~WE: RN3.5 (R4), U18.15 (B3); also elsewhere on the board
SYT_~WE_E: U18.5 (A3); also elsewhere on the board
S_{0}: RN1.2 (R1), U14.18 (B0); also elsewhere on the board
S_{1}: RN1.3 (R2), U14.17 (B1); also elsewhere on the board
S_{2}: RN1.4 (R3), U14.16 (B2); also elsewhere on the board
S_{3}: RN1.5 (R4), U14.15 (B3); also elsewhere on the board
S_{4}: RN1.6 (R5), U14.14 (B4); also elsewhere on the board
S_{5}: RN1.7 (R6), U14.13 (B5); also elsewhere on the board
S_{6}: RN1.8 (R7), U14.12 (B6); also elsewhere on the board
T_~OE: RN3.2 (R1), U17.18 (B0), U18.18 (B0); also elsewhere on the board
T_~OE_E: U18.2 (A0); also elsewhere on the board
T_~WE: RN3.3 (R2), U17.17 (B1), U18.17 (B1); also elsewhere on the board
T_~WE_E: U18.3 (A1); also elsewhere on the board
~OPERATE: U17.19 (CE); also elsewhere on the board
~PROGRAM: U18.19 (CE); also elsewhere on the board
~STAT_BUF: U16.19 (CE); also elsewhere on the board
~SYMB_BUF: U14.19 (CE); also elsewhere on the board

Notes on the sheet:
IN-OPERATION CONTROL LINES BUFFER
IN-PROGRAM CONTROL LINES BUFFERS
5V for writing 0V for reading (programmer-wise)

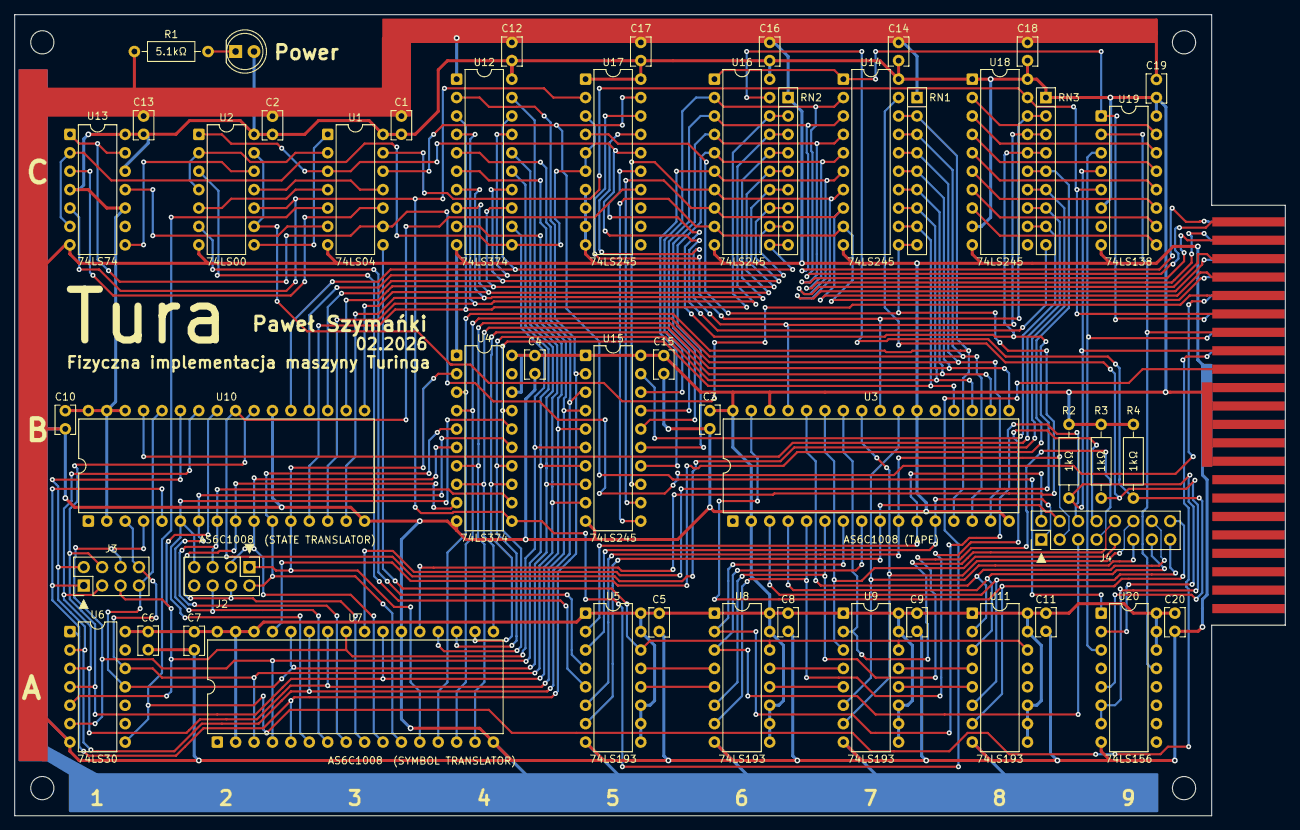
[picture p16: board turing_machine.kicad_pcb from above]

Board: 2 copper layers, 175.3 x 110.5 mm, 52 parts (0 on the bottom side), 102 nets.
