szymanp135/Tura/(commit log)

2026-02-06 init commit
    [controlbuffers.kicad_sch, exestatepower.kicad_sch, turing_machine.kicad_pcb, turing_machine.kicad_sch]
2026-02-06 PCB layout planning and further documantation work
    [controlbuffers.kicad_sch, exestatepower.kicad_sch, turing_machine.kicad_pcb, turing_machine.kicad_sch]
2026-02-06 finished PCB planning
    [exestatepower.kicad_sch, turing_machine.kicad_pcb]
2026-02-07 fixed schematics bugs and updated documentation
    [controlbuffers.kicad_sch, exestatepower.kicad_sch, turing_machine.kicad_sch]
2026-02-07 adjusted PCB design for schematic fixes
    [exestatepower.kicad_sch, turing_machine.kicad_pcb]
2026-02-07 added edge connector to PCB
    [exestatepower.kicad_sch, turing_machine.kicad_pcb]
2026-02-07 small border ground plane adjustments and added backside logos
    [turing_machine.kicad_pcb]
2026-02-07 small cosmetic PCB changes
    [turing_machine.kicad_pcb, turing_machine.kicad_sch]
2026-02-08 added two connectors to schematics and PCB design and reformatted slightly documentation
    [exestatepower.kicad_sch, turing_machine.kicad_pcb]
2026-02-08 moved Header Position output from main connector to dedicated one and updated documentation for that
    [exestatepower.kicad_sch, turing_machine.kicad_pcb]
2026-02-11 added driver
    [clkinterfaces.kicad_sch, exestatepower.kicad_sch, led.kicad_sch, turing_driver.kicad_pcb, turing_driver.kicad_sch, turing_machine.kicad_pcb]
2026-02-14 added control panel and moved LEDs to it
    [clkinterfaces.kicad_sch, control_panel.kicad_pcb, control_panel.kicad_sch, led.kicad_sch, turing_driver.kicad_pcb, turing_driver.kicad_sch]
2026-02-15 finished driver PCB layout
    [clkinterfaces.kicad_sch, led.kicad_sch, turing_driver.kicad_pcb, turing_driver.kicad_sch]
2026-02-20 added some wiring and fixed few schematic bugs
    [led.kicad_sch, turing_driver.kicad_pcb, turing_driver.kicad_sch]
2026-02-20 finished driver PCB wiring and added some marks
    [turing_driver.kicad_pcb]
2026-02-21 added few markings to PCBs
    [turing_driver.kicad_pcb, turing_machine.kicad_pcb]
2026-02-22 added backplane
    [backplane.kicad_pcb, backplane.kicad_sch]
2026-03-20 added github links to core and driver boards
    [turing_driver.kicad_pcb, turing_machine.kicad_pcb]
2026-03-20 added backplane PCB and adjusted driver silkscreen text thickness
    [backplane.kicad_pcb, backplane.kicad_sch, turing_driver.kicad_pcb]
